phorton1/Arduino-esp32_cnc20mm/docs/projects.md

# esp32_cnc20mm - some Projects made with this CNC machine

**[Home](readme.md)** --
**[Design](design.md)** --
**[Details](details.md)** --
**[Electronics](electronics.md)** --
**[Box](box.md)** --
**[Spindle](spindle.md)** --
**[Y-Axis](y_axis.md)** --
**[Table](table.md)** --
**[Build](build.md)** --
**[Laser](laser.md)** --
**[Accessories](accessories.md)** --
**[Software](software.md)** --
**[Notes](notes.md)** --
**Projects**

- Mo's Plaque
- Mark's Emblem
- Rhapsody Engraving
- Dolphin Plaques
- Boat Numbering
- Small Things Box

New Laser

- Bocas Del Toro Box
- Fabian Box
- Wirth Boxes
- Useless Box
- Clock1 & 2
- Clock3

**Next** - back to the [**beginning**](readme.md) ...
