phorton1/Arduino-esp32_cnc20mm/docs/images/access-dust_boot2.jpg

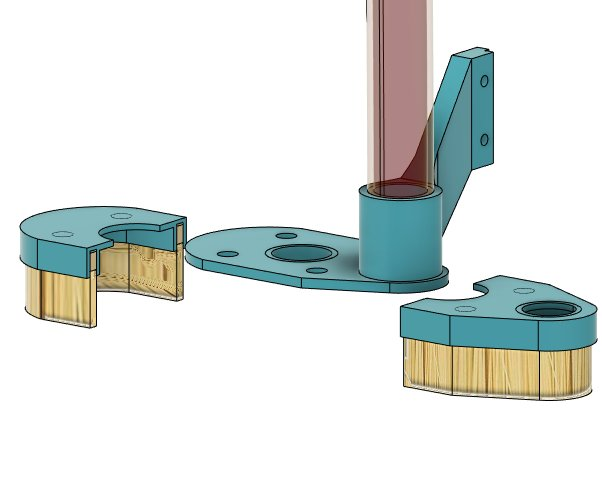
docs/images/access-dust_boot2.jpg
