phorton1/Arduino-esp32_cnc20mm/docs/images/box-CuttingWood_thumb.jpg

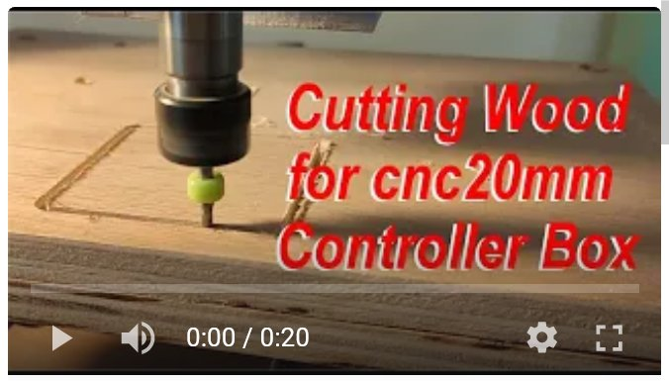
docs/images/box-CuttingWood_thumb.jpg
