phorton1/Arduino-esp32_cnc20mm/docs/images/brush.jpg

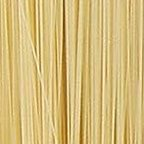
docs/images/brush.jpg
