phorton1/Arduino-esp32_cnc20mm/docs/images/design-table0.jpg

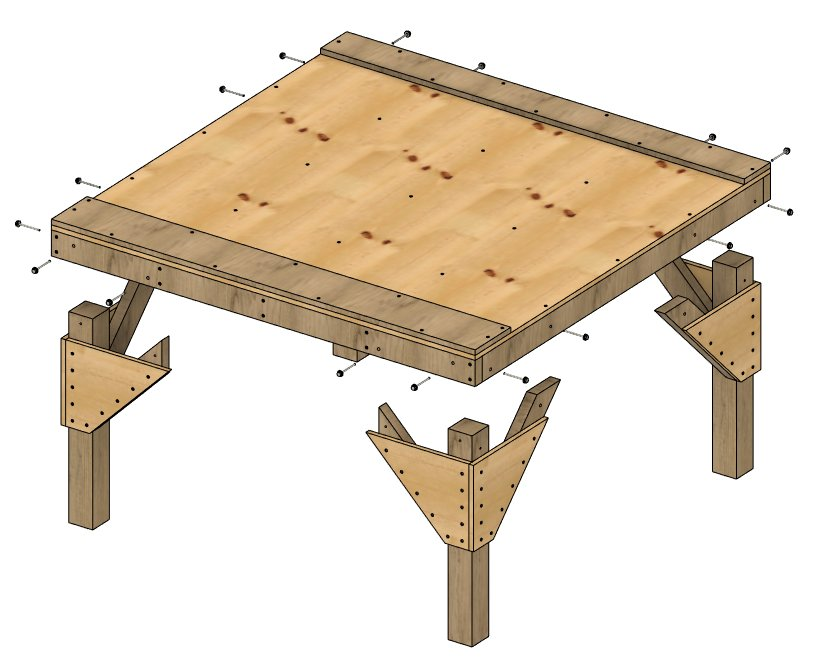
docs/images/design-table0.jpg
