phorton1/Arduino-esp32_cnc20mm/docs/z_extra/lumber_by_4s.jpg

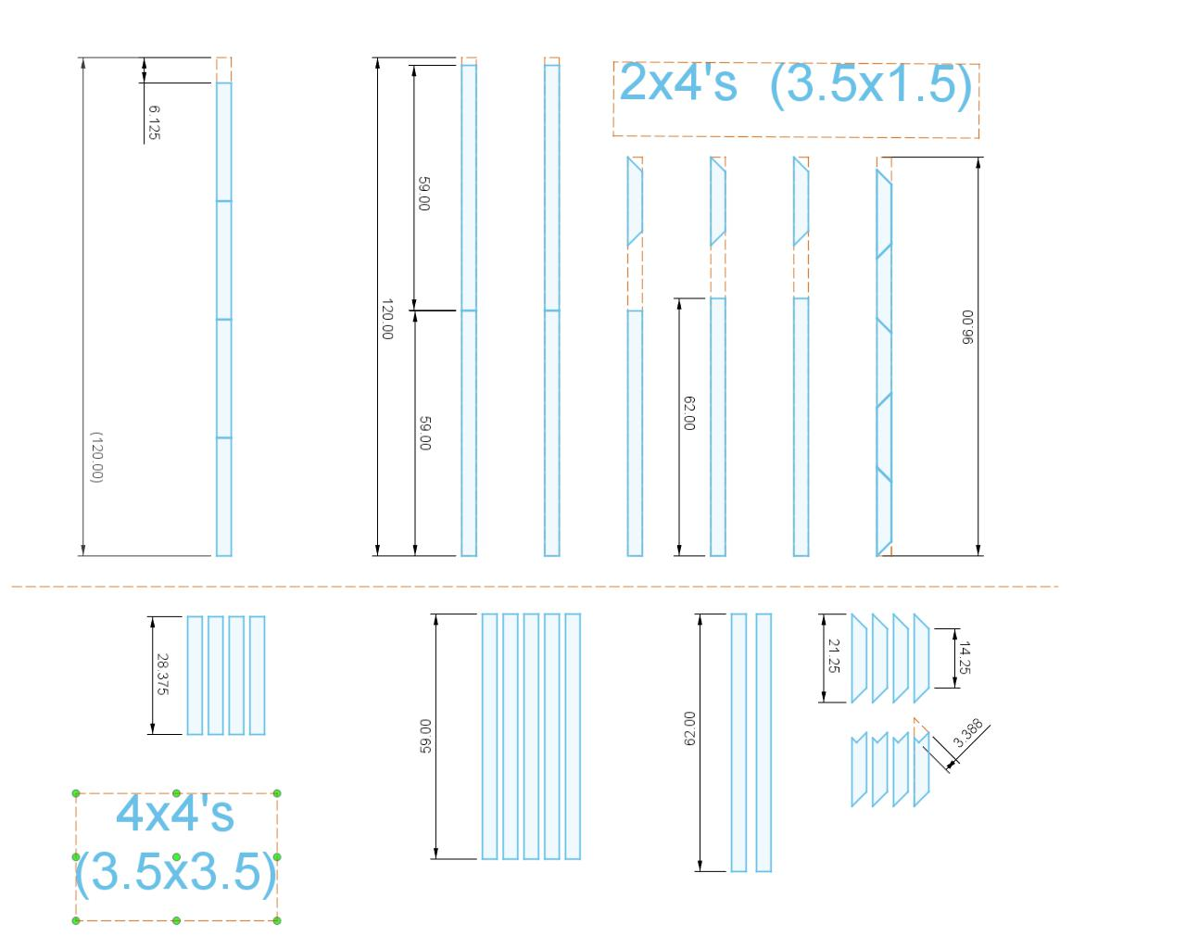
docs/z_extra/lumber_by_4s.jpg
