phorton1/Arduino-esp32_cnc20mm/docs/z_extra/plywood.jpg

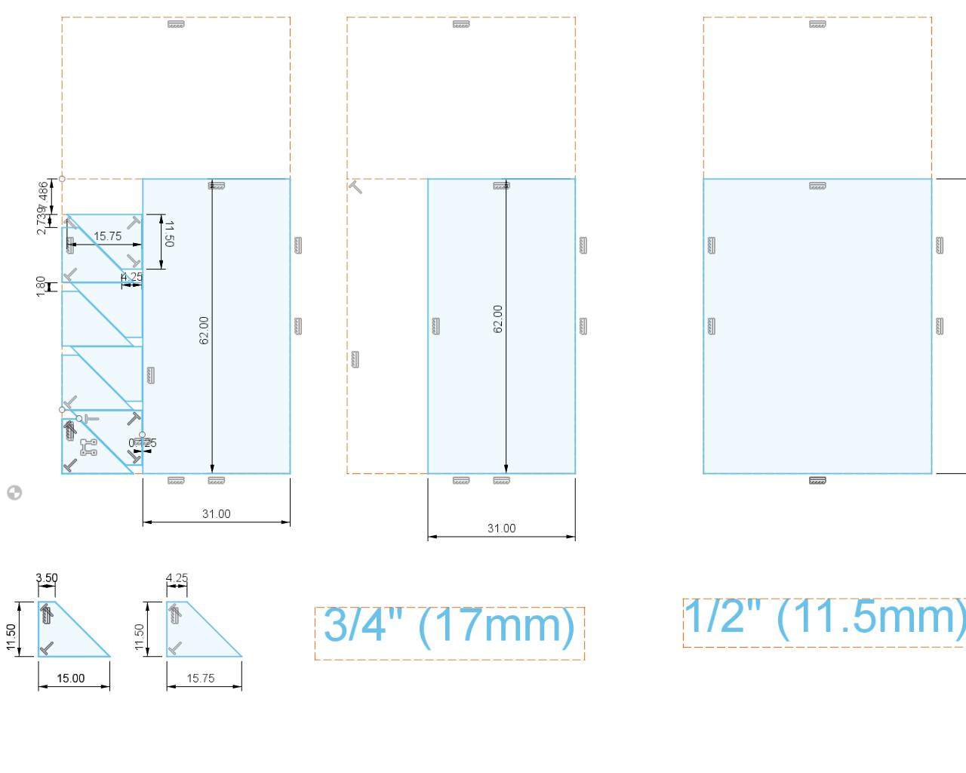
docs/z_extra/plywood.jpg
