phorton1/Arduino-esp32_cnc20mm/docs/fusion/stl_box/right_plastic.stl

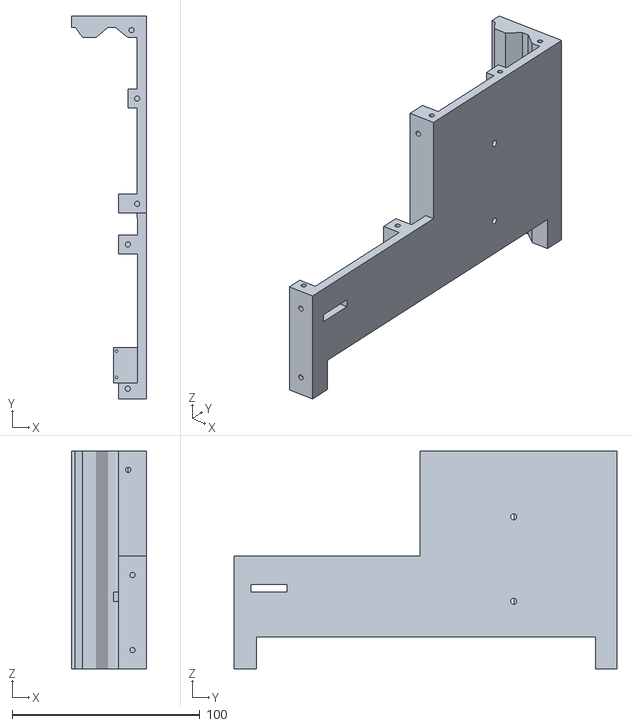
[picture p115: CAD file, 2023-07-21]
docs/fusion/stl_box/right_plastic.stl
40.0 x 204.0 x 116.0
