phorton1/Arduino-esp32_cnc20mm/docs/fusion/stl_machine/x_fixed_end.stl

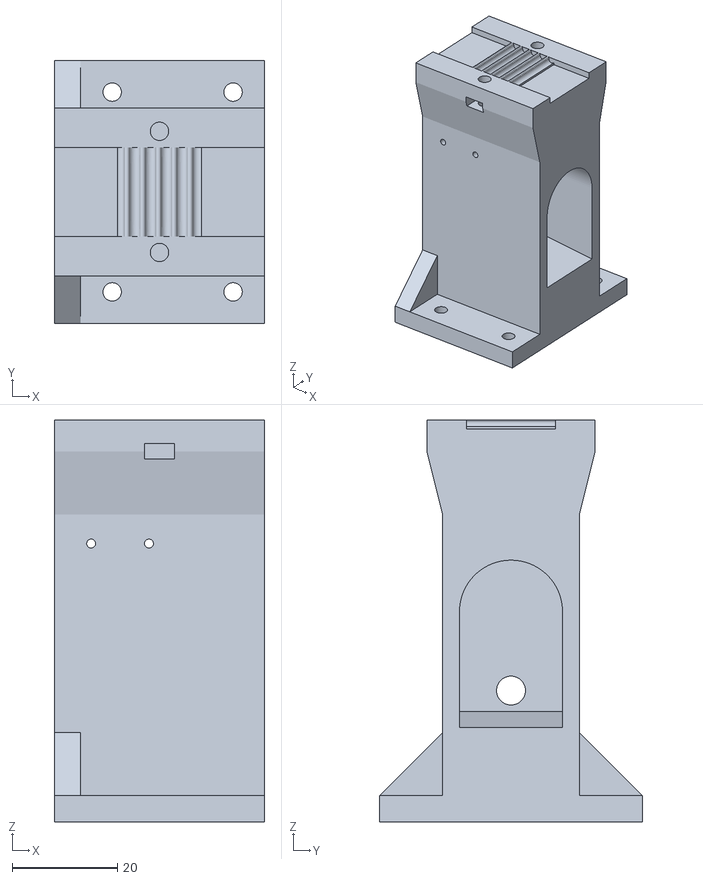
[picture p116: CAD file, 2023-07-24]
docs/fusion/stl_machine/x_fixed_end.stl
40.0 x 50.0 x 76.5
