phorton1/Arduino-esp32_cnc20mm/docs/fusion/stl_other/vacuum2_hose_connector.stl

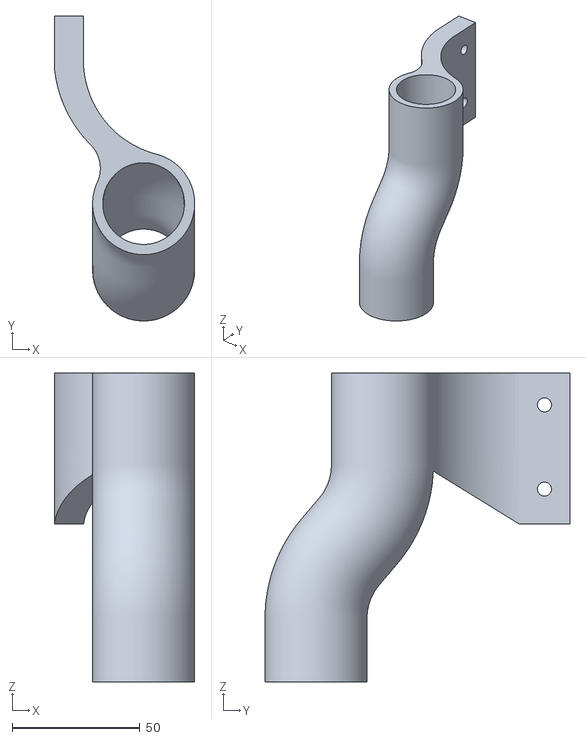
[picture p117: CAD file, 2023-07-25]
docs/fusion/stl_other/vacuum2_hose_connector.stl
55.0 x 119.5 x 121.0
