phorton1/Arduino-esp32_cnc20mm/docs/kicad/laser_board/laser_board.step

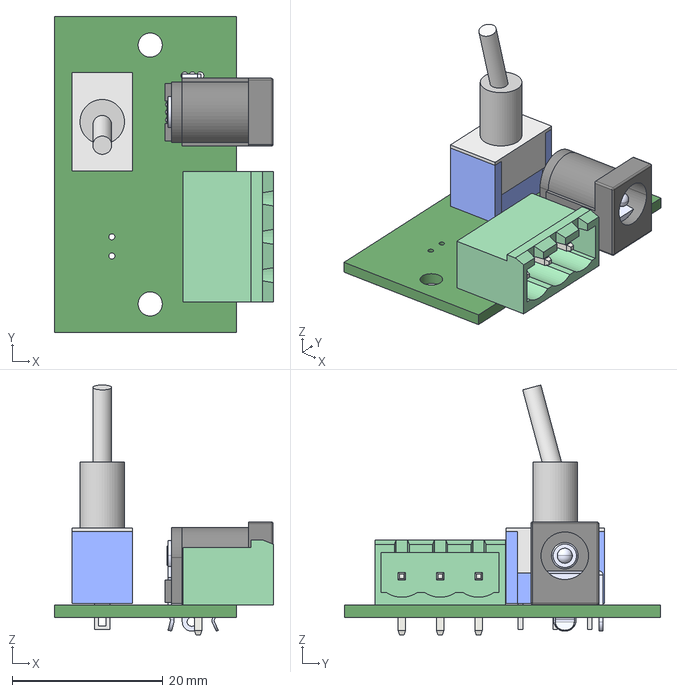
[picture p118: CAD file, 2023-07-28]
docs/kicad/laser_board/laser_board.step
29.1 x 41.9 x 33.1 mm
