phorton1/Arduino-esp32_cnc20mm/docs/prusa/box/power_connector_mount.3mf

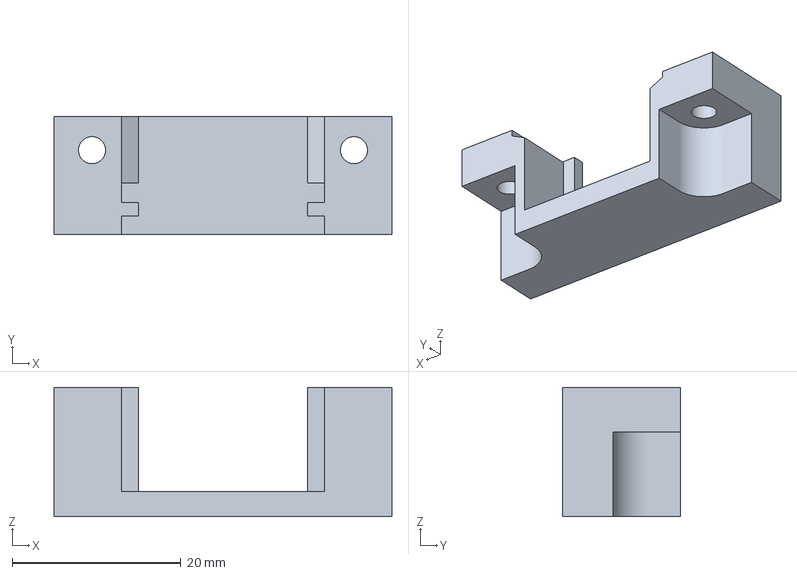
[picture p119: CAD file, 2023-07-21]
docs/prusa/box/power_connector_mount.3mf
40.0 x 14.0 x 15.3 mm
