phorton1/Arduino-esp32_cnc20mm/docs/prusa/machine/x_bearing_x_4.3mf

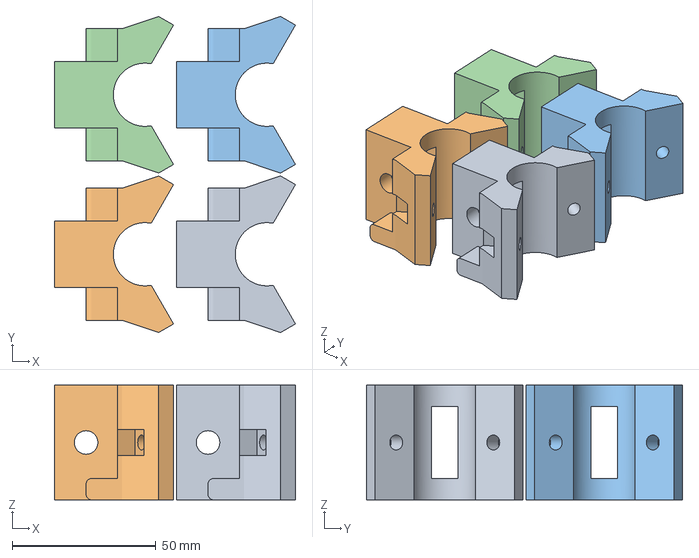
[picture p120: CAD file, 2023-07-24]
docs/prusa/machine/x_bearing_x_4.3mf
83.9 x 110.1 x 40.0 mm
x_bearing.stl x 4
