phorton1/Arduino-esp32_cnc20mm/docs/fusion/stl_box/big_mount.stl

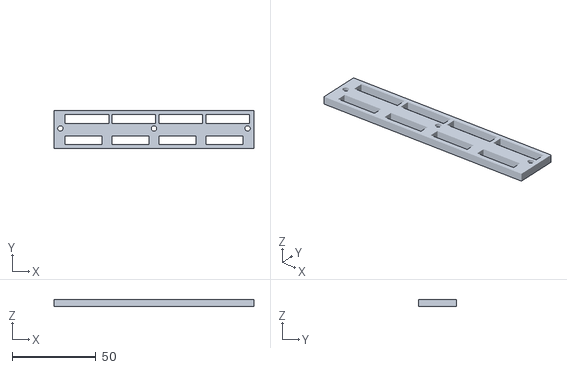
[picture p121: CAD file, 2023-07-21]
docs/fusion/stl_box/big_mount.stl
119.4 x 22.9 x 4.00
