phorton1/Arduino-esp32_cnc20mm/docs/fusion/stl_machine/x_bearing.stl

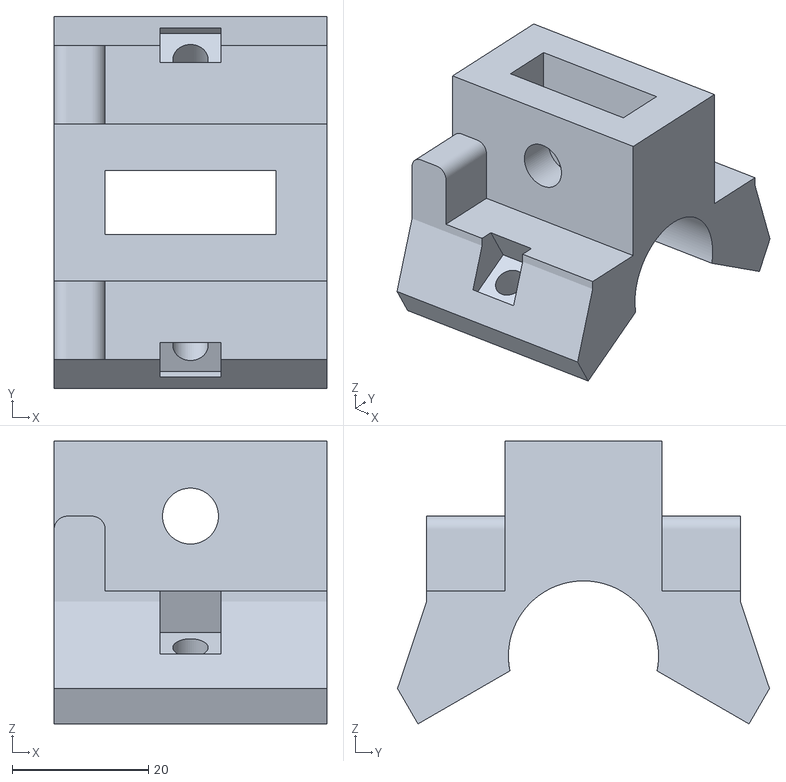
[picture p122: CAD file, 2023-07-24]
docs/fusion/stl_machine/x_bearing.stl
40.0 x 54.5 x 41.5
