phorton1/Arduino-esp32_cnc20mm/docs/fusion/stl_other/laser_scoop.stl

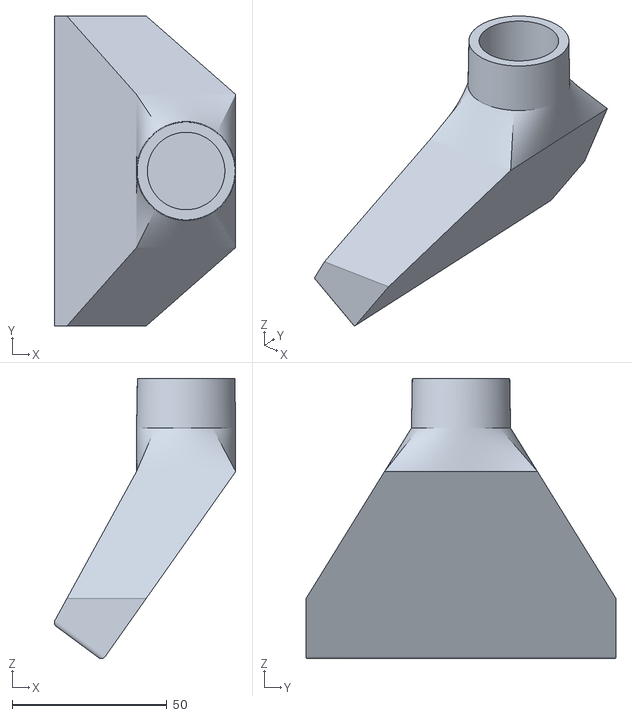
[picture p123: CAD file, 2023-07-25]
docs/fusion/stl_other/laser_scoop.stl
58.5 x 100.0 x 90.4
