phorton1/Arduino-esp32_cnc20mm/docs/prusa/machine/x_end_set.3mf

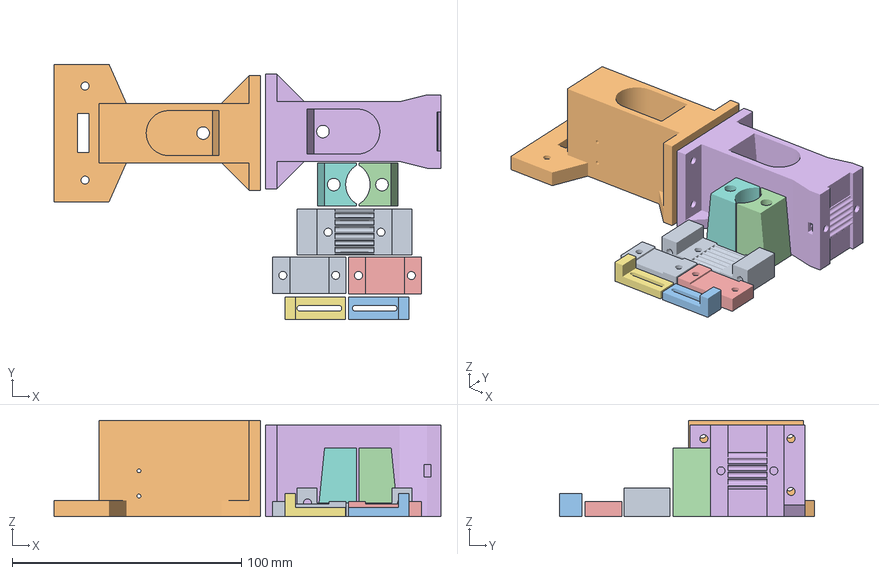
[picture p124: CAD file, 2023-07-24]
docs/prusa/machine/x_end_set.3mf
168.7 x 111.4 x 42.0 mm
x_tensioner.stl
x_adj_end.stl
x_stop.stl x 2
x_bar_tensioner.stl x 2
x_end_top.stl x 2
x_fixed_end.stl
