phorton1/Arduino-esp32_cnc20mm/docs/fusion/stl_box/middle_plastic.stl

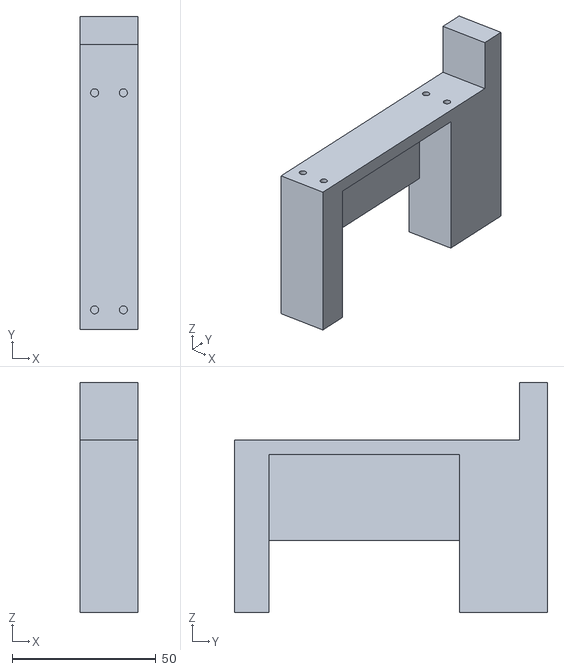
[picture p125: CAD file, 2023-07-21]
docs/fusion/stl_box/middle_plastic.stl
20.0 x 109.0 x 80.0
