phorton1/Arduino-esp32_cnc20mm/docs/fusion/stl_machine/drag_support_bracket.stl

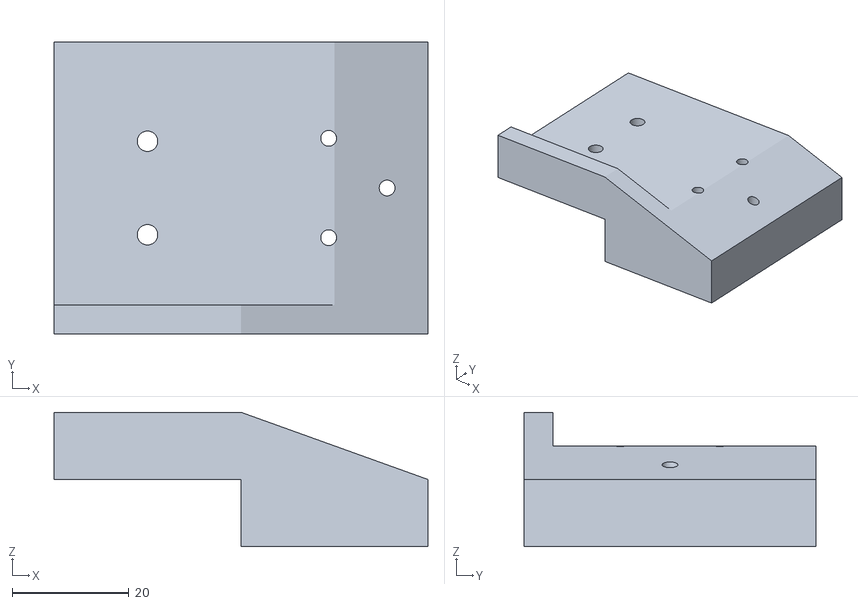
[picture p126: CAD file, 2023-07-22]
docs/fusion/stl_machine/drag_support_bracket.stl
64.0 x 50.0 x 23.0
