phorton1/Arduino-esp32_cnc20mm/docs/prusa/box/other_parts.3mf

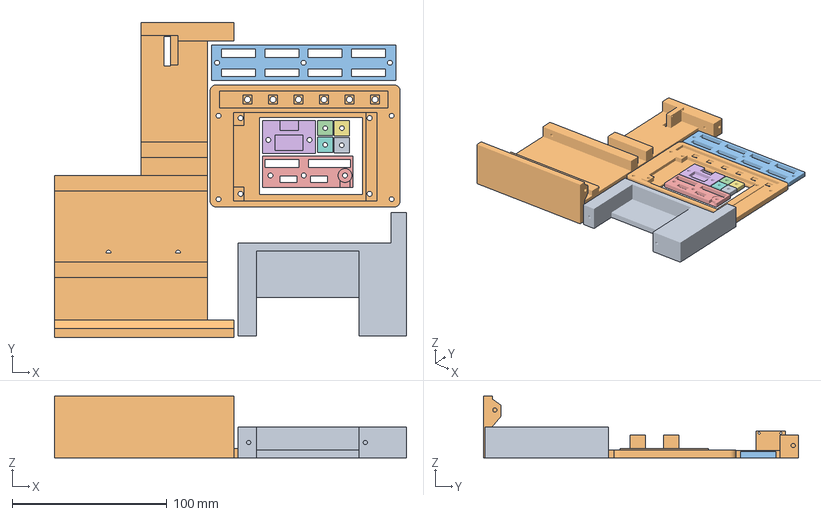
[picture p127: CAD file, 2023-07-21]
docs/prusa/box/other_parts.3mf
227.7 x 204.0 x 40.0 mm
middle_plastic.stl
screen_mount.stl
big_mount.stl
pcb_mount.stl x 4
small_mount.stl
usb_mount.stl
right_plastic.stl
