phorton1/Arduino-esp32_cnc20mm/docs/prusa/other/laser_scoop.3mf

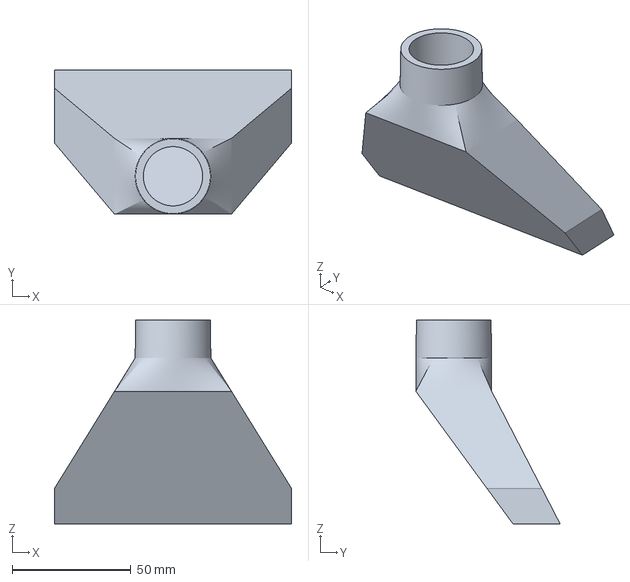
[picture p128: CAD file, 2023-07-25]
docs/prusa/other/laser_scoop.3mf
100.0 x 60.9 x 86.0 mm
