phorton1/Arduino-esp32_cnc20mm/docs/fusion/stl_machine/y_tensioner.stl

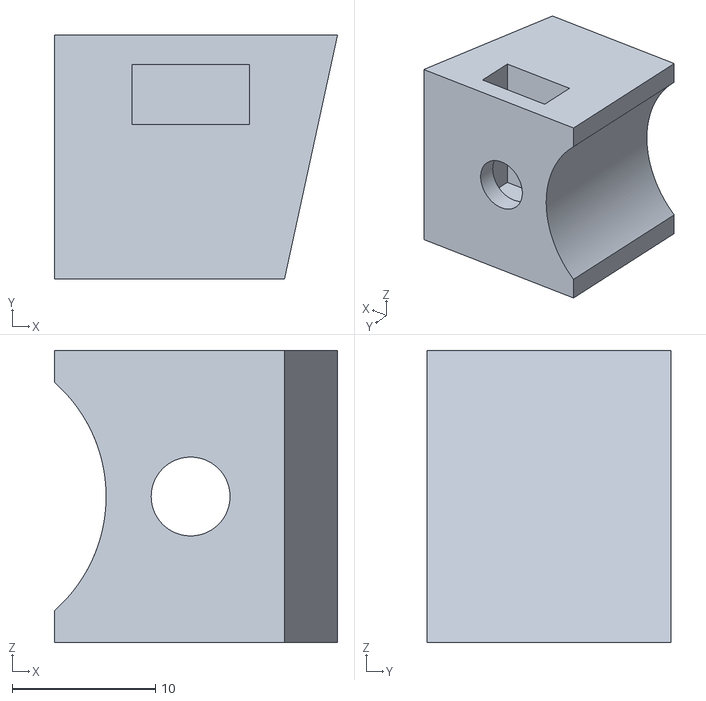
[picture p129: CAD file, 2023-07-21]
docs/fusion/stl_machine/y_tensioner.stl
19.8 x 17.0 x 20.4
