phorton1/Arduino-esp32_cnc20mm/docs/fusion/stl_other/wire_clamp1.stl

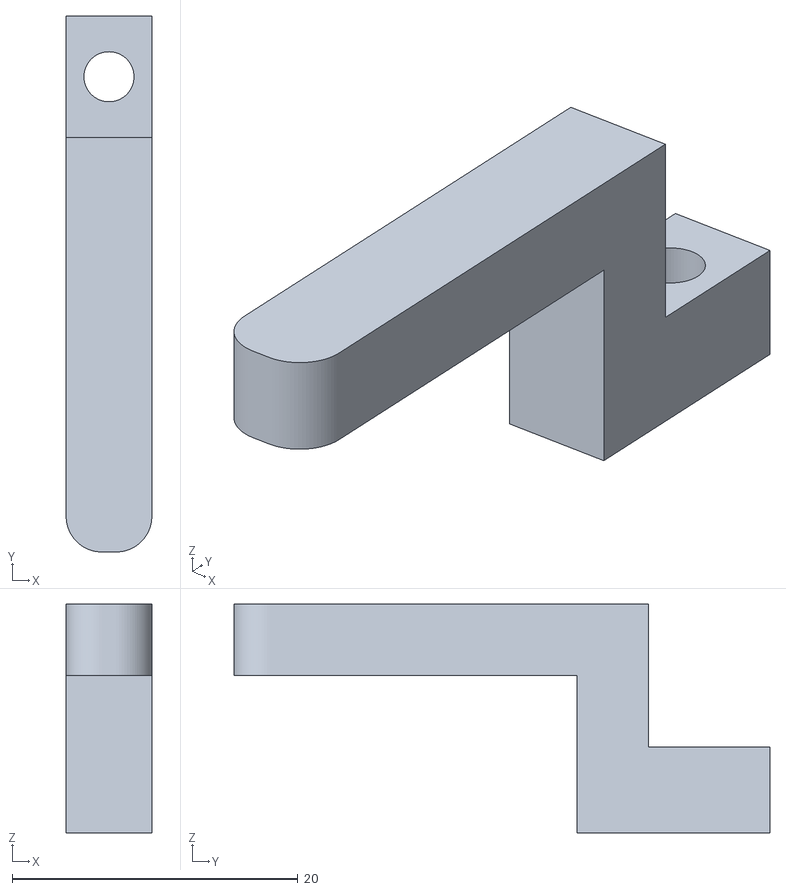
[picture p130: CAD file, 2023-07-21]
docs/fusion/stl_other/wire_clamp1.stl
6.00 x 37.5 x 16.0
