phorton1/Arduino-esp32_cnc20mm/docs/prusa/box/left_plastic.3mf

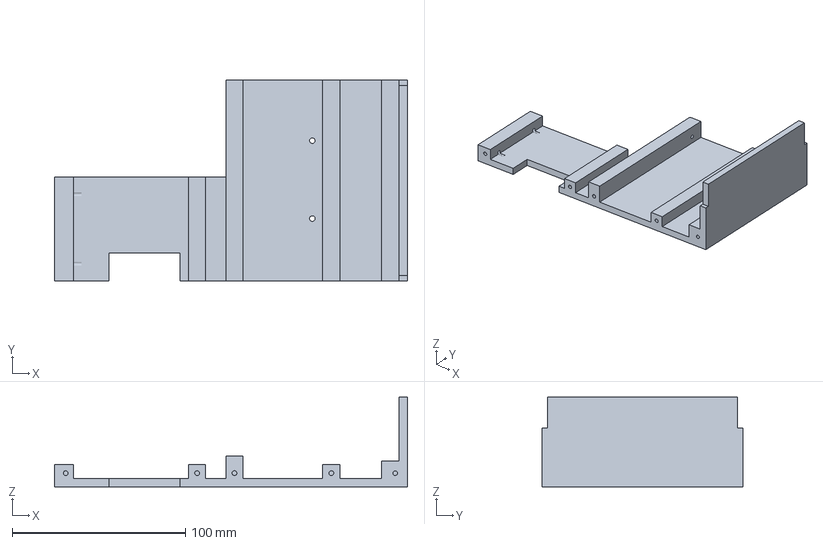
[picture p131: CAD file, 2023-07-21]
docs/prusa/box/left_plastic.3mf
204.0 x 116.0 x 52.0 mm
