phorton1/Arduino-esp32_cnc20mm/docs/prusa/machine/x_tensioner.3mf

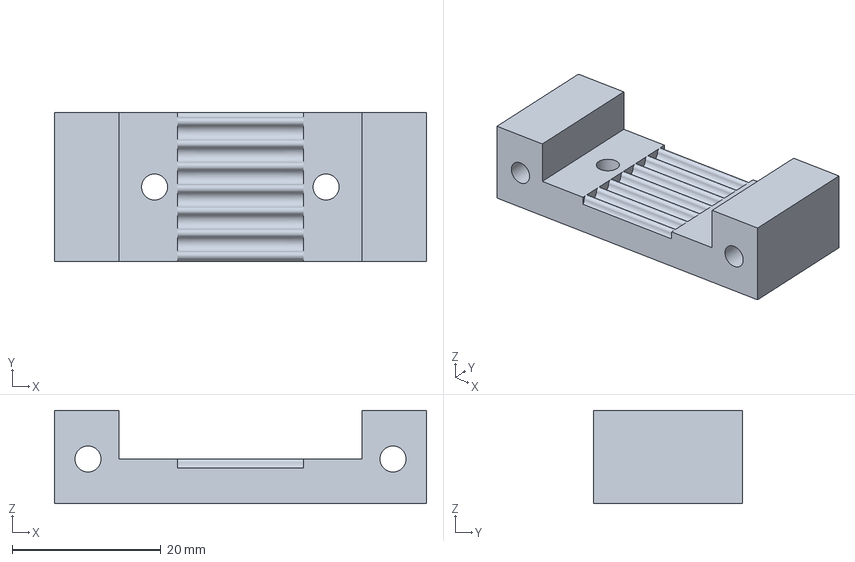
[picture p132: CAD file, 2023-07-21]
docs/prusa/machine/x_tensioner.3mf
50.0 x 20.0 x 12.5 mm
