phorton1/Arduino-esp32_cnc20mm/docs/prusa/other/10mm_hose_clamp.3mf

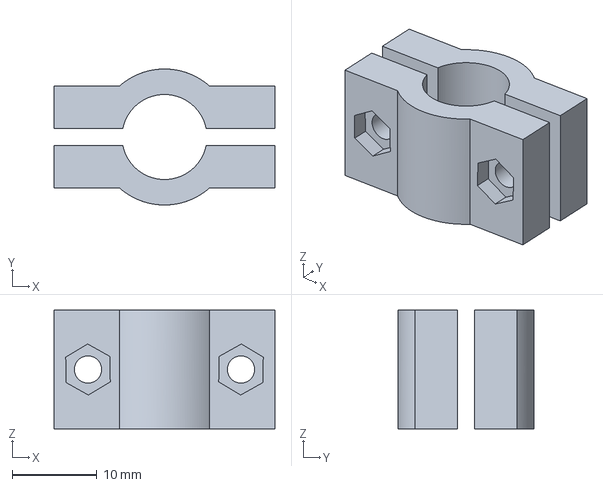
[picture p133: CAD file, 2023-07-21]
docs/prusa/other/10mm_hose_clamp.3mf
26.0 x 16.0 x 14.0 mm
