phorton1/Arduino-esp32_cnc20mm/docs/fusion/stl_machine/y_drag_bracket.stl

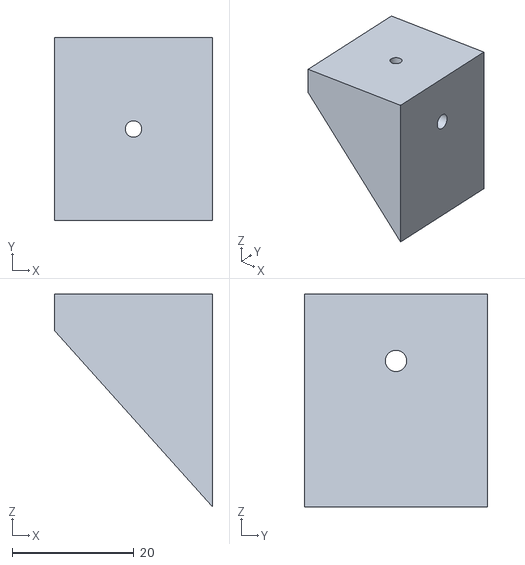
[picture p134: CAD file, 2023-07-21]
docs/fusion/stl_machine/y_drag_bracket.stl
26.0 x 30.0 x 35.0
