phorton1/Arduino-esp32_cnc20mm/docs/fusion/stl_other/vacuum_base_attacher.stl

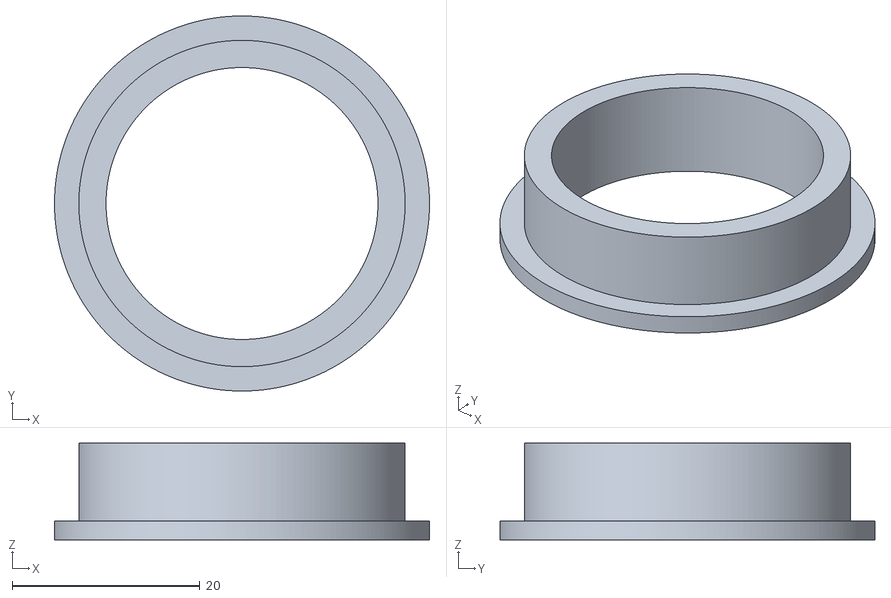
[picture p135: CAD file, 2023-07-21]
docs/fusion/stl_other/vacuum_base_attacher.stl
40.0 x 40.0 x 10.3
