phorton1/Arduino-esp32_cnc20mm/docs/prusa/box/spindle_box_cover.3mf

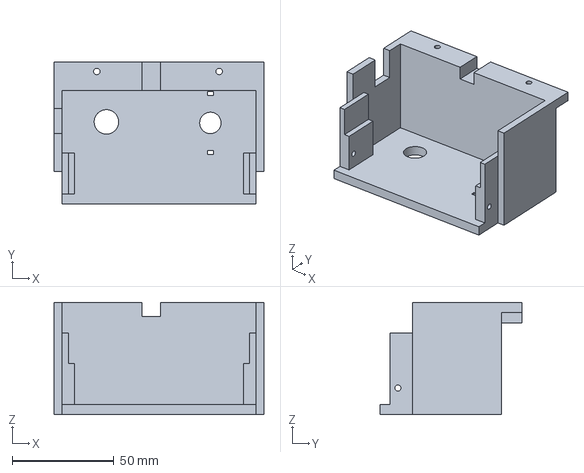
[picture p136: CAD file, 2023-07-21]
docs/prusa/box/spindle_box_cover.3mf
103.0 x 69.7 x 55.0 mm
