phorton1/Arduino-esp32_cnc20mm/docs/prusa/machine/x_tube_support.3mf

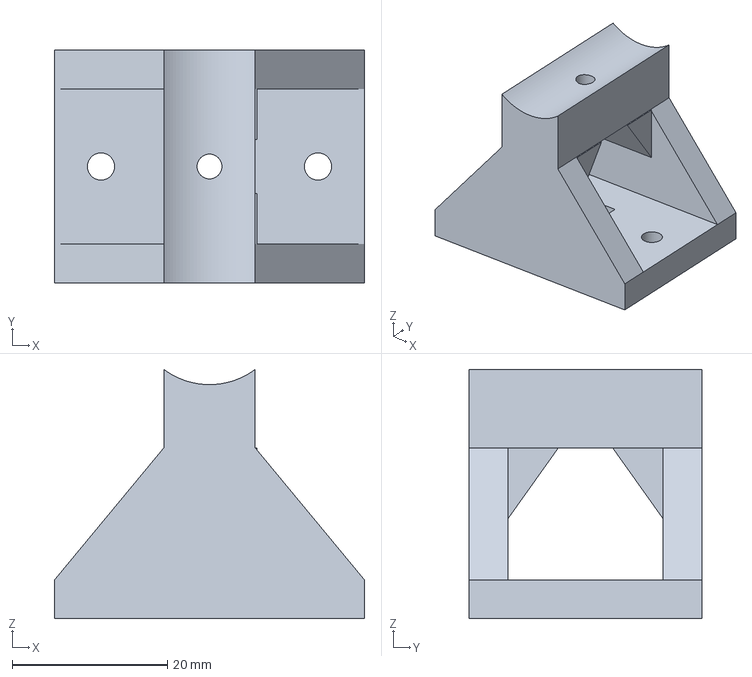
[picture p137: CAD file, 2023-07-21]
docs/prusa/machine/x_tube_support.3mf
40.0 x 30.0 x 32.2 mm
