phorton1/Arduino-esp32_cnc20mm/docs/prusa/other/connector_brackets1.3mf

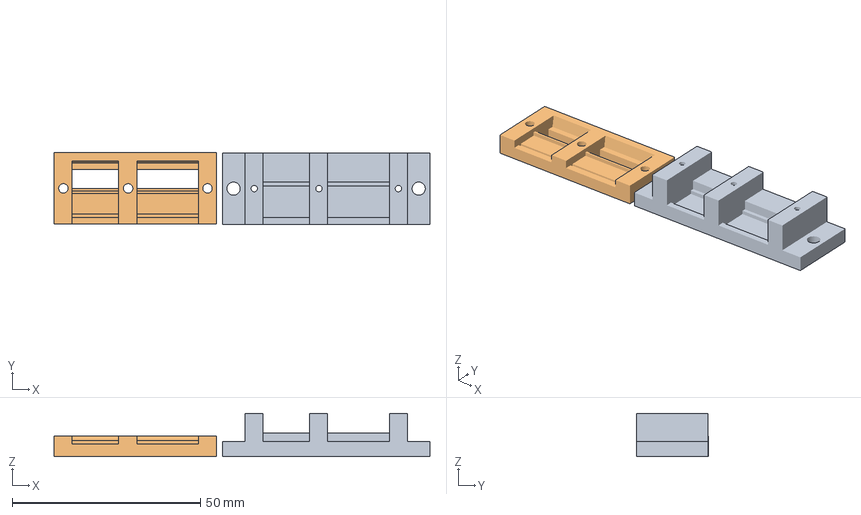
[picture p138: CAD file, 2023-07-21]
docs/prusa/other/connector_brackets1.3mf
99.9 x 19.1 x 11.5 mm
four_three_base.stl
four_three_top.stl
