phorton1/Arduino-esp32_cnc20mm/docs/fusion/stl_box/laser_board_mount.stl

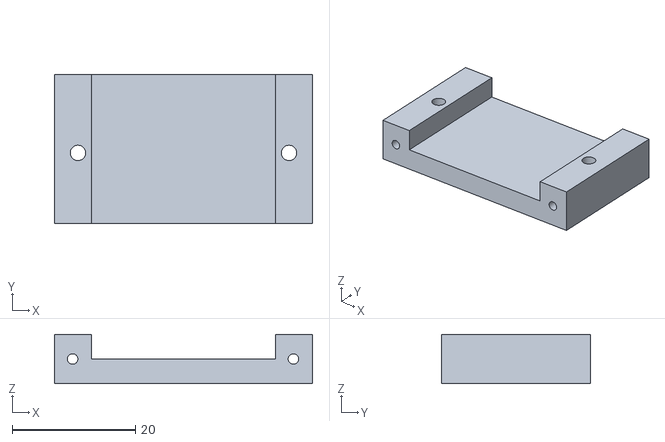
[picture p139: CAD file, 2023-07-21]
docs/fusion/stl_box/laser_board_mount.stl
41.9 x 24.1 x 8.00
