phorton1/Arduino-esp32_cnc20mm/docs/prusa/machine/z_lim_set.3mf

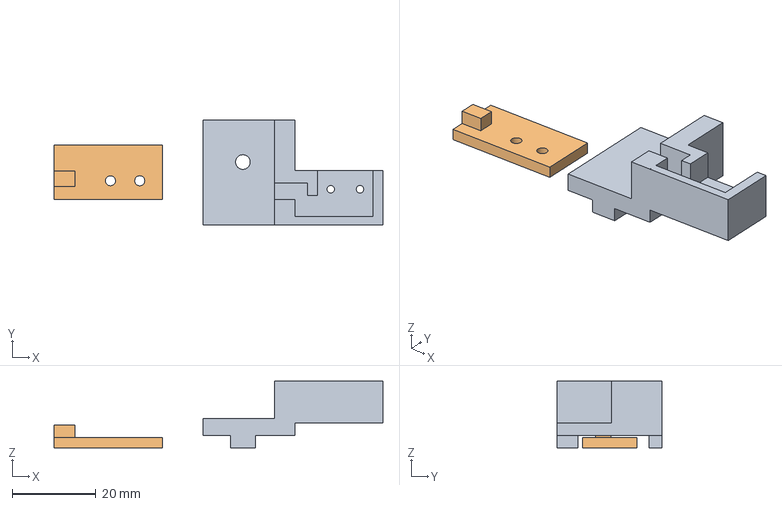
[picture p141: CAD file, 2023-07-21]
docs/prusa/machine/z_lim_set.3mf
78.7 x 25.0 x 16.0 mm
z_lim_base.stl
z_lim_cover.stl
