phorton1/Arduino-esp32_cnc20mm/docs/prusa/other/vacuum_attachment.3mf

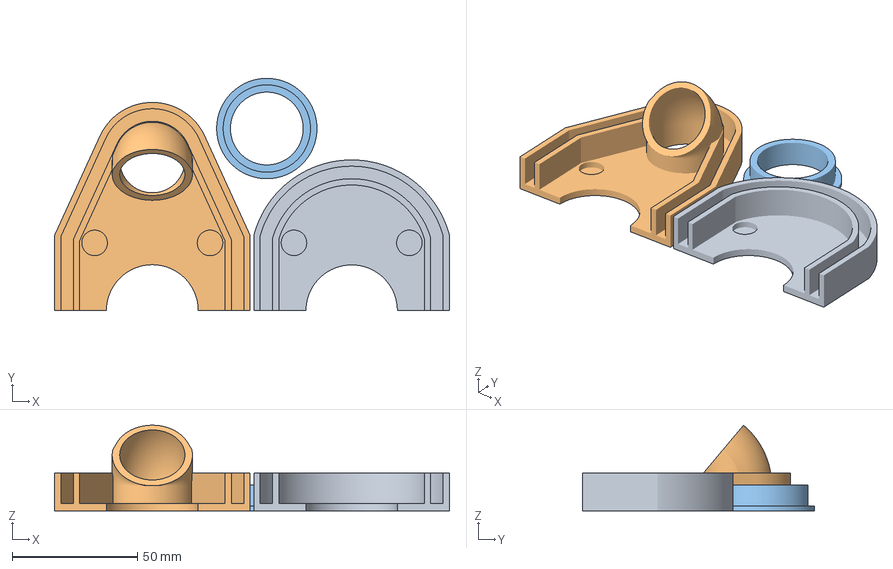
[picture p142: CAD file, 2023-07-21]
docs/prusa/other/vacuum_attachment.3mf
157.5 x 92.6 x 34.1 mm
vacuum_boot2.stl
vacuum_boot1.stl
vacuum_base_attacher.stl
