phorton1/Arduino-esp32_cnc20mm/docs/fusion/stl_box/screen_mount.stl

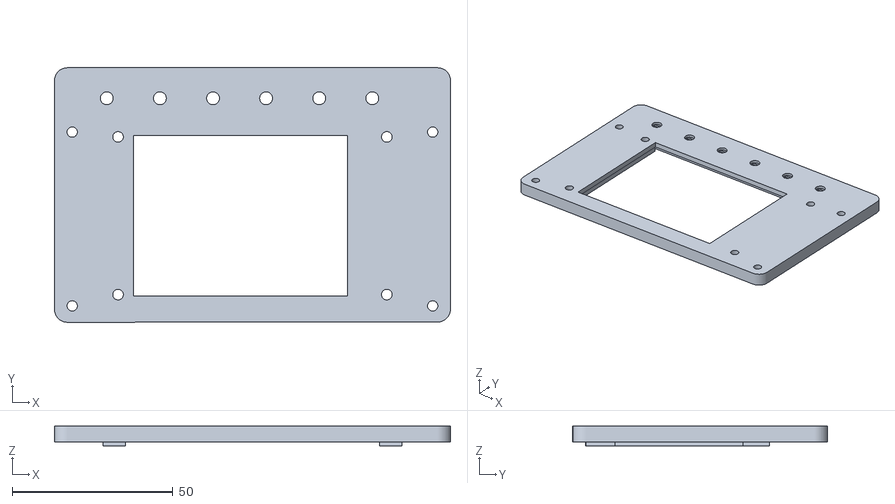
[picture p143: CAD file, 2023-07-21]
docs/fusion/stl_box/screen_mount.stl
123.0 x 79.1 x 6.20
