phorton1/Arduino-esp32_cnc20mm/docs/fusion/stl_machine/z_lim_cover.stl

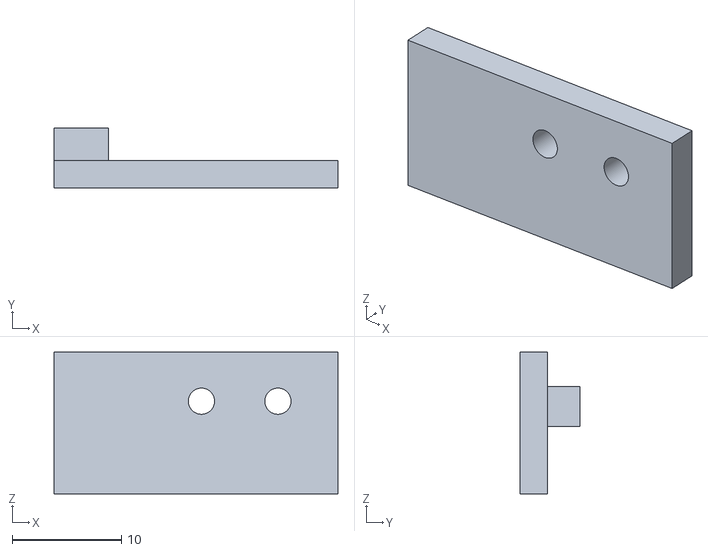
[picture p144: CAD file, 2023-07-21]
docs/fusion/stl_machine/z_lim_cover.stl
26.0 x 5.50 x 13.0
