phorton1/Arduino-esp32_cnc20mm/docs/fusion/stl_other/vacuum_boot1.stl

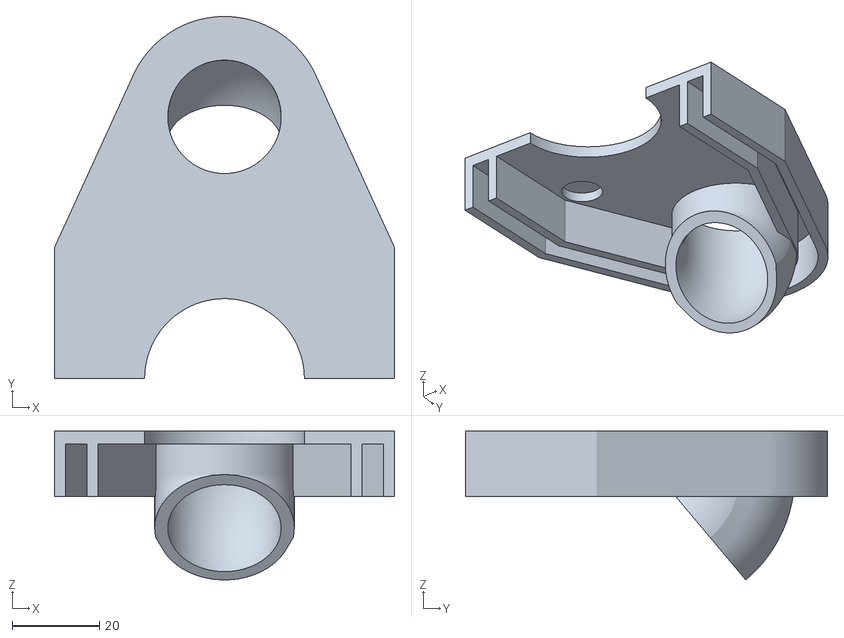
[picture p145: CAD file, 2023-07-21]
docs/fusion/stl_other/vacuum_boot1.stl
78.0 x 83.0 x 34.1
