phorton1/Arduino-esp32_cnc20mm/docs/prusa/machine/y_connector.3mf

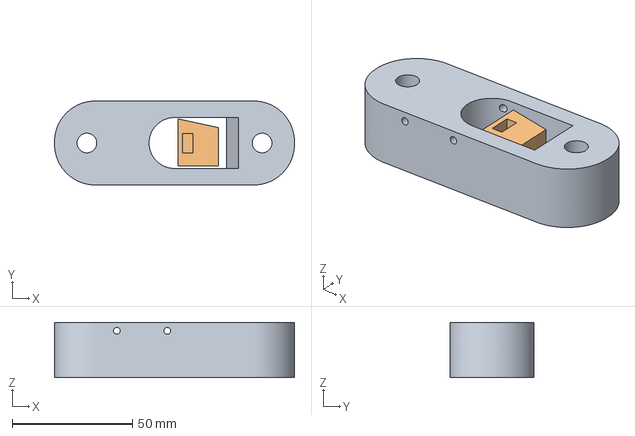
[picture p146: CAD file, 2023-07-21]
docs/prusa/machine/y_connector.3mf
100.0 x 35.0 x 23.0 mm
y_connector.stl
y_tensioner.stl
