phorton1/Arduino-esp32_cnc20mm/docs/prusa/other/vacuum_base.3mf

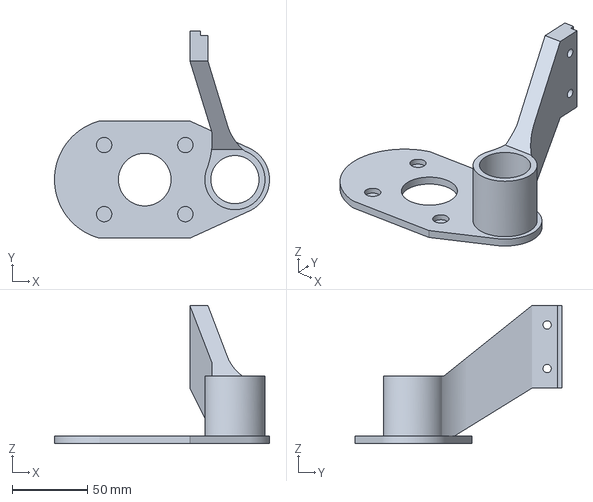
[picture p147: CAD file, 2023-07-21]
docs/prusa/other/vacuum_base.3mf
143.0 x 138.0 x 91.9 mm
