phorton1/Arduino-esp32_cnc20mm/docs/fusion/stl_other/vacuum_boot2.stl

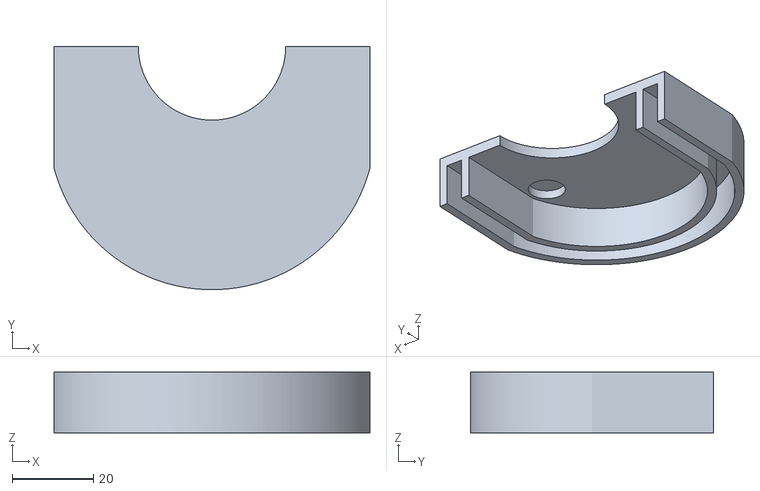
[picture p149: CAD file, 2023-07-21]
docs/fusion/stl_other/vacuum_boot2.stl
78.0 x 60.1 x 15.0
