phorton1/Arduino-esp32_cnc20mm/docs/prusa/machine/y_drag_support_brackets.3mf

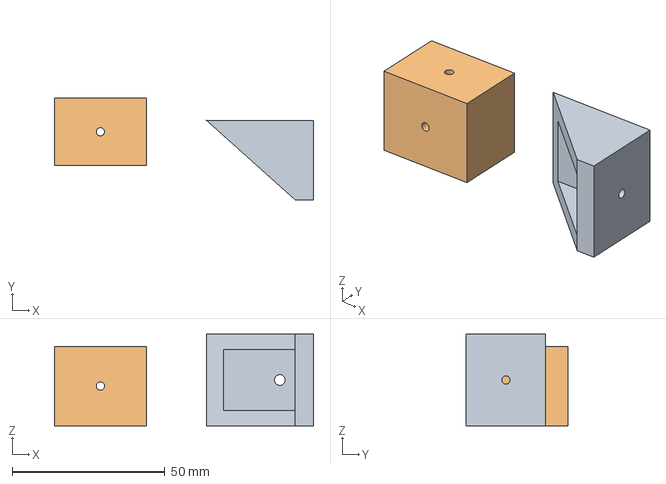
[picture p150: CAD file, 2023-07-21]
docs/prusa/machine/y_drag_support_brackets.3mf
84.7 x 33.3 x 30.0 mm
y_drag_bracket.stl
y_drag_spacer.stl
