phorton1/Arduino-esp32_cnc20mm/docs/fusion/stl_box/pcb_mount.stl

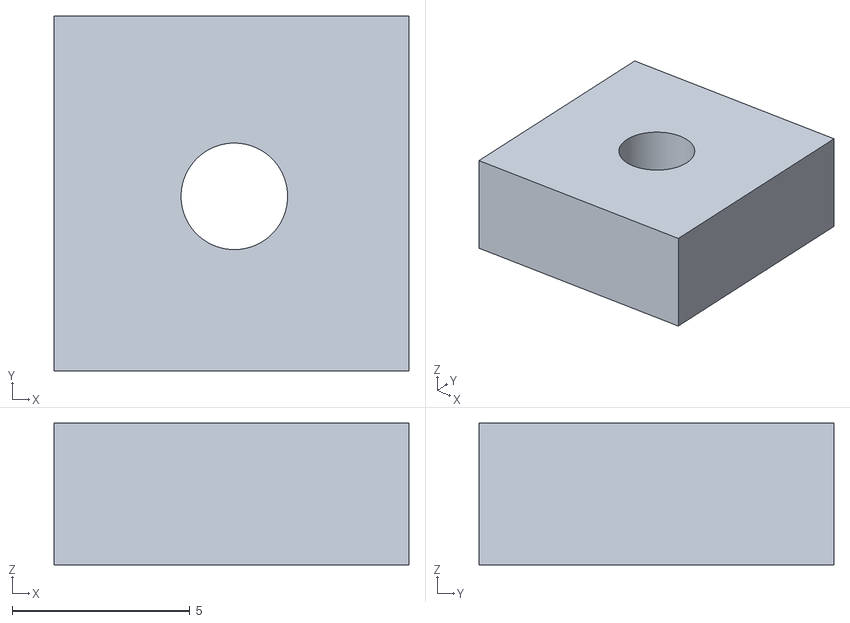
[picture p151: CAD file, 2023-07-21]
docs/fusion/stl_box/pcb_mount.stl
10.0 x 10.0 x 4.00
