phorton1/Arduino-esp32_cnc20mm/docs/fusion/stl_machine/y_tensioner_plate.stl

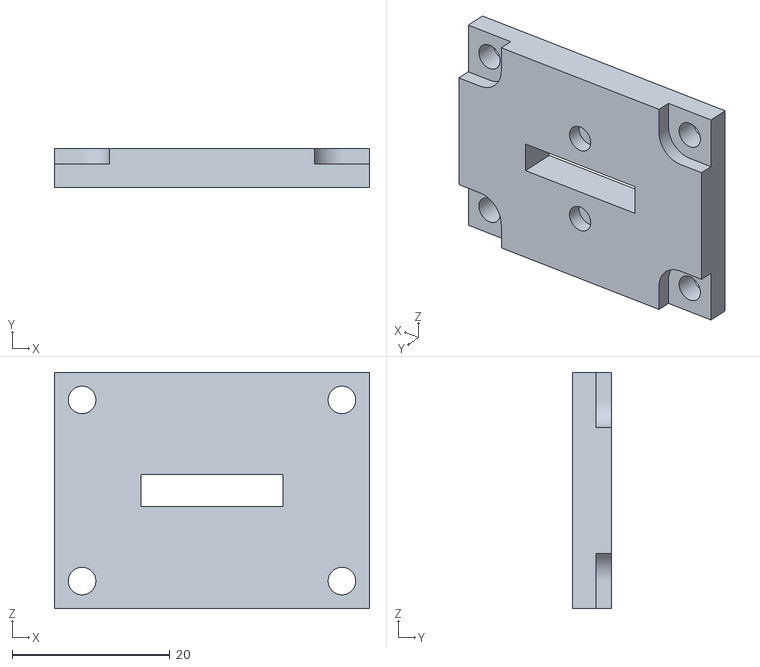
[picture p152: CAD file, 2023-07-21]
docs/fusion/stl_machine/y_tensioner_plate.stl
40.0 x 5.00 x 30.0
