phorton1/Arduino-esp32_cnc20mm/docs/prusa/machine/x_tube_support_x_8.3mf

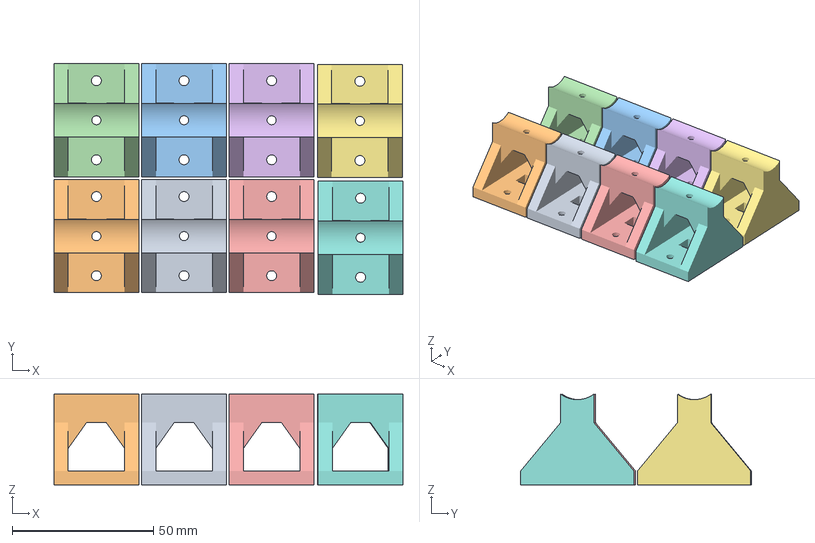
[picture p153: CAD file, 2023-07-21]
docs/prusa/machine/x_tube_support_x_8.3mf
123.5 x 81.6 x 32.2 mm
x_tube_support.stl x 8
