phorton1/Arduino-esp32_cnc20mm/docs/fusion/stl_box/small_mount.stl

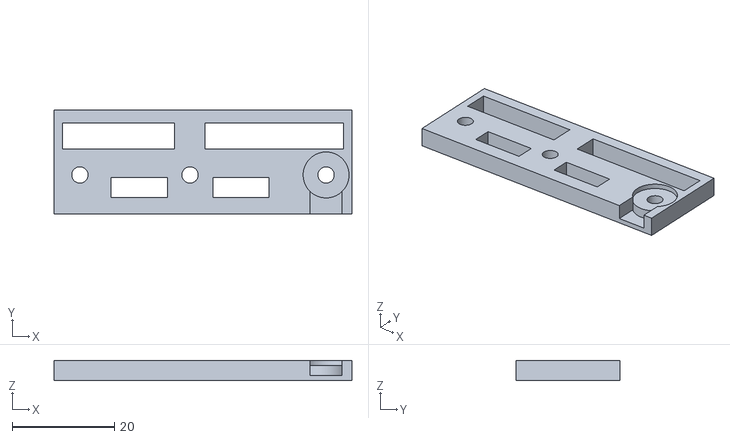
[picture p154: CAD file, 2023-07-21]
docs/fusion/stl_box/small_mount.stl
58.4 x 20.3 x 4.00
