phorton1/Arduino-esp32_cnc20mm/docs/fusion/stl_machine/y_drag_support.stl

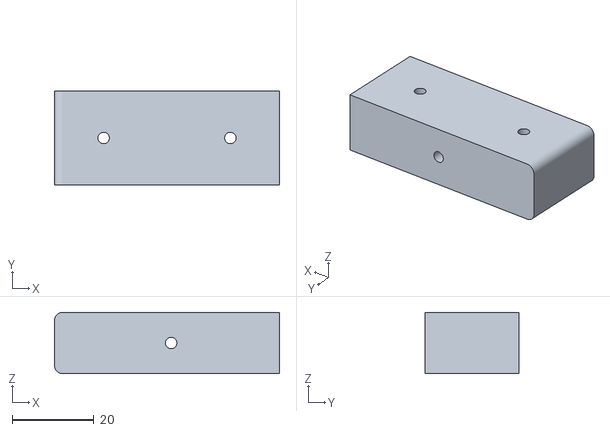
[picture p155: CAD file, 2023-07-21]
docs/fusion/stl_machine/y_drag_support.stl
55.0 x 23.0 x 15.0
