phorton1/Arduino-esp32_cnc20mm/docs/fusion/stl_other/four_three_base.stl

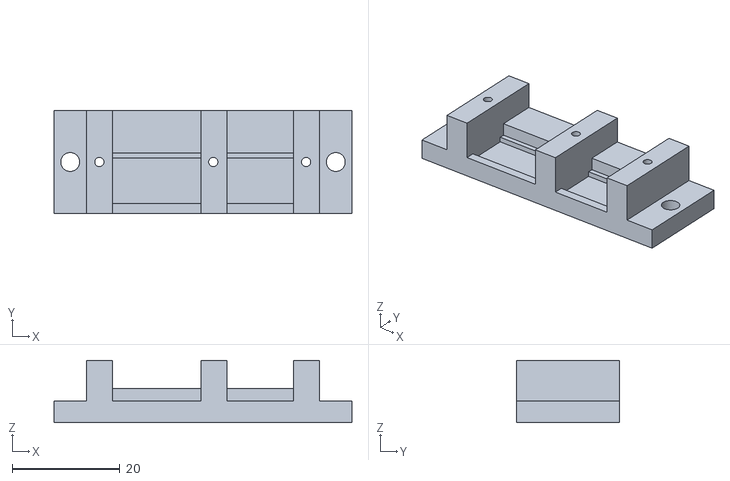
[picture p156: CAD file, 2023-07-21]
docs/fusion/stl_other/four_three_base.stl
55.2 x 19.0 x 11.5
