phorton1/Arduino-esp32_cnc20mm/docs/prusa/machine/z_zero_set.3mf

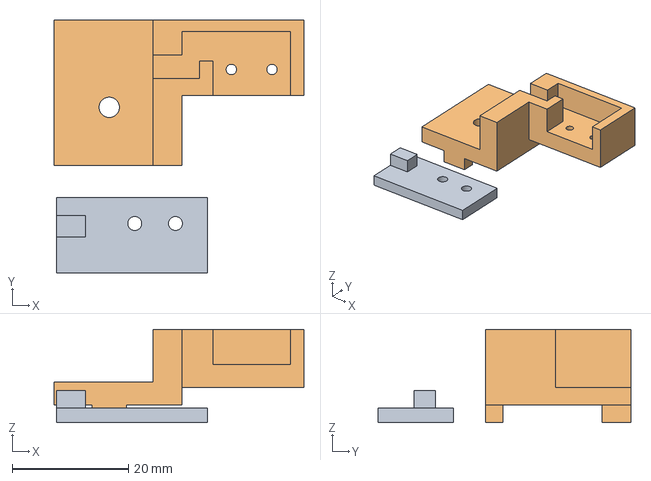
[picture p157: CAD file, 2023-07-21]
docs/prusa/machine/z_zero_set.3mf
43.0 x 43.5 x 16.0 mm
z_zero_cover.stl
z_zero_base.stl
