phorton1/Arduino-esp32_cnc20mm/docs/fusion/stl_box/usb_mount.stl

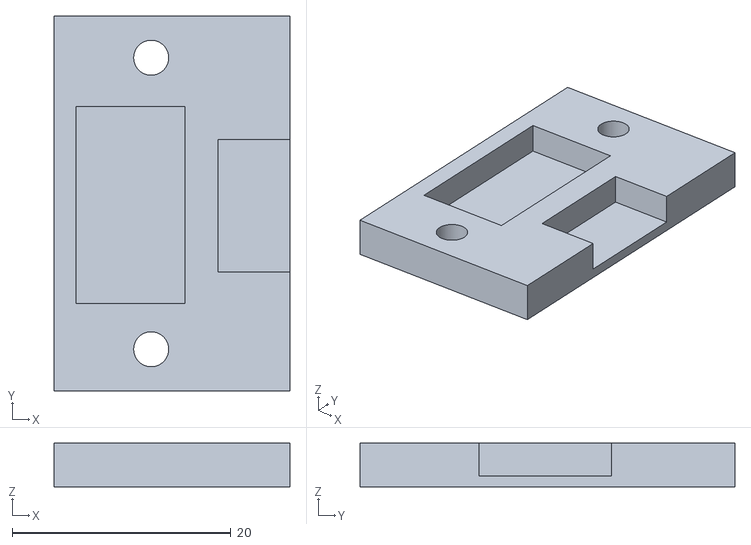
[picture p158: CAD file, 2023-07-21]
docs/fusion/stl_box/usb_mount.stl
21.6 x 34.3 x 4.00
