phorton1/Arduino-esp32_cnc20mm/docs/fusion/stl_machine/y_tensioner_top.stl

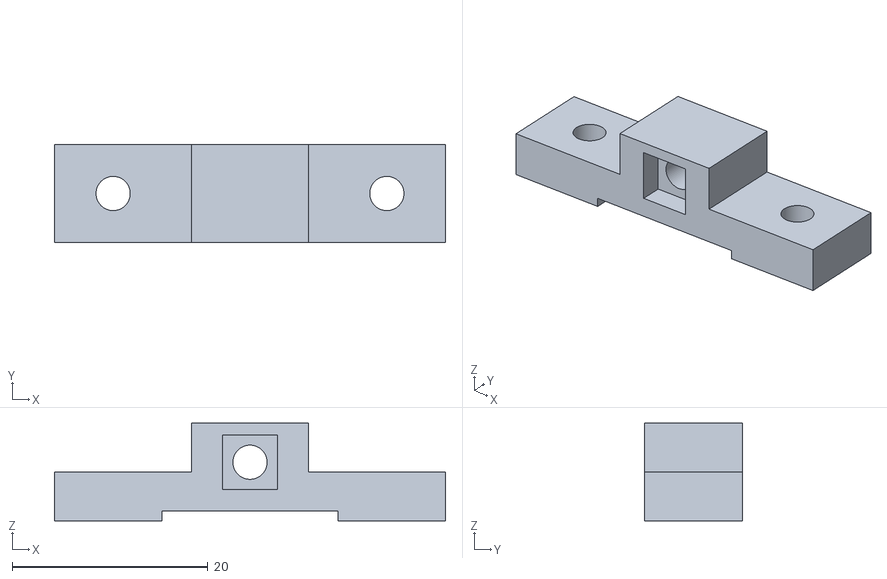
[picture p159: CAD file, 2023-07-21]
docs/fusion/stl_machine/y_tensioner_top.stl
40.0 x 10.0 x 10.0
