phorton1/Arduino-esp32_cnc20mm/docs/fusion/stl_other/three_two_base.stl

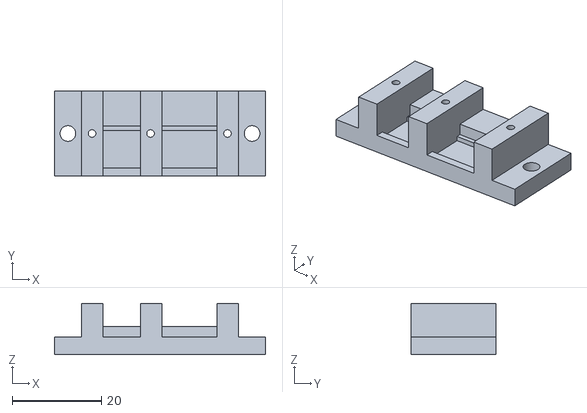
[picture p160: CAD file, 2023-07-21]
docs/fusion/stl_other/three_two_base.stl
47.2 x 19.0 x 11.5
