phorton1/Arduino-esp32_cnc20mm/docs/prusa/machine/y_drag_support_x_2.3mf

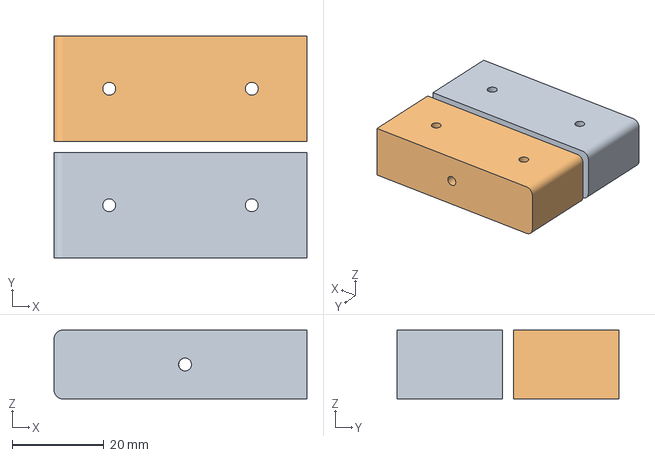
[picture p161: CAD file, 2023-07-21]
docs/prusa/machine/y_drag_support_x_2.3mf
55.0 x 48.4 x 15.0 mm
y_drag_support.stl x 2
