phorton1/Arduino-esp32_cnc20mm/docs/fusion/stl_machine/z_lim_base.stl

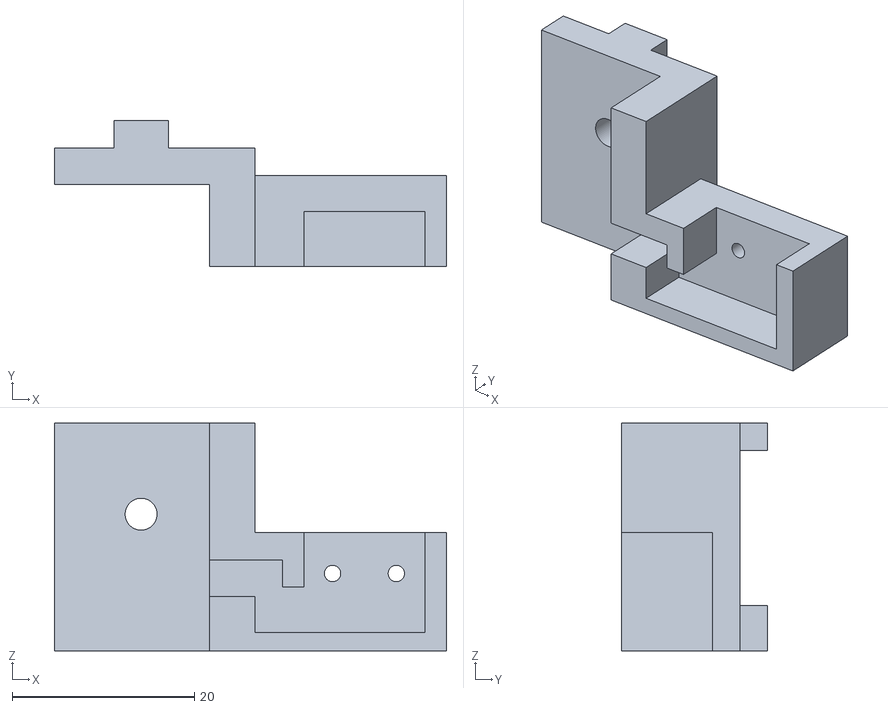
[picture p162: CAD file, 2023-07-21]
docs/fusion/stl_machine/z_lim_base.stl
43.0 x 16.0 x 25.0
