phorton1/Arduino-esp32_cnc20mm/docs/fusion/stl_machine/y_bearing_half.stl

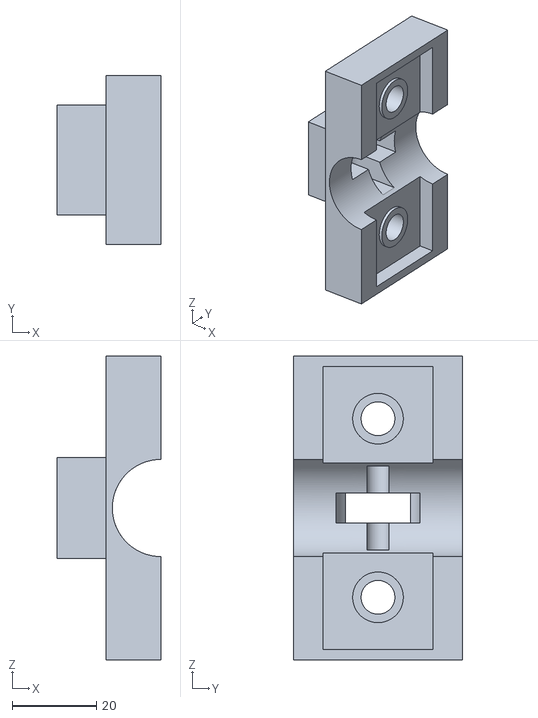
[picture p163: CAD file, 2023-07-21]
docs/fusion/stl_machine/y_bearing_half.stl
24.7 x 40.0 x 72.0
