phorton1/Arduino-esp32_cnc20mm/docs/fusion/stl_other/four_base.stl

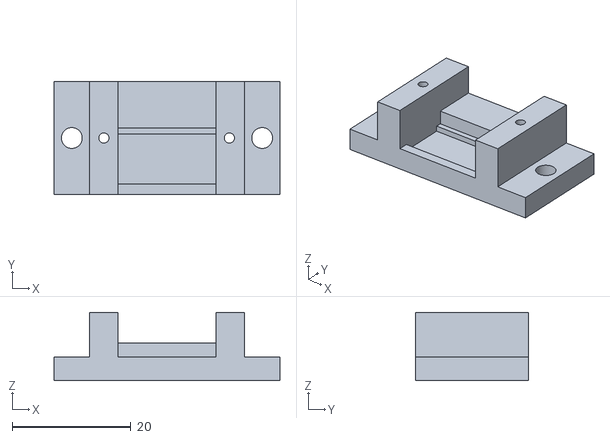
[picture p164: CAD file, 2023-07-21]
docs/fusion/stl_other/four_base.stl
38.0 x 19.0 x 11.5
