phorton1/Arduino-esp32_cnc20mm/docs/prusa/machine/last_black_parts.3mf

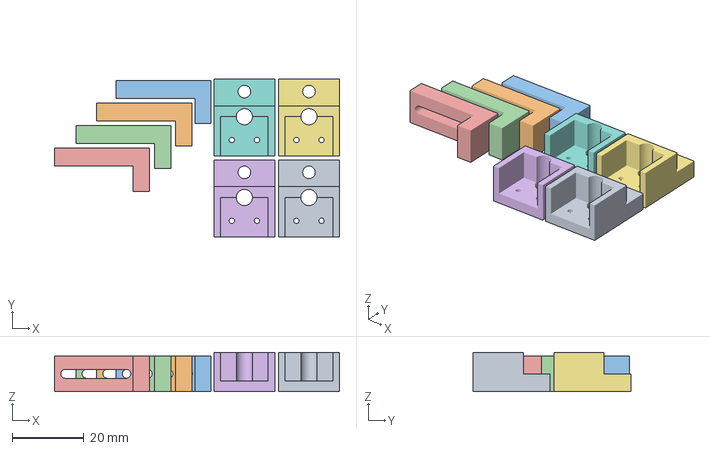
[picture p165: CAD file, 2023-07-21]
docs/prusa/machine/last_black_parts.3mf
79.4 x 44.0 x 11.0 mm
x_limit_mount.stl x 4
x_stop.stl x 4
