phorton1/Arduino-esp32_cnc20mm/docs/fusion/stl_other/two_two_base.stl

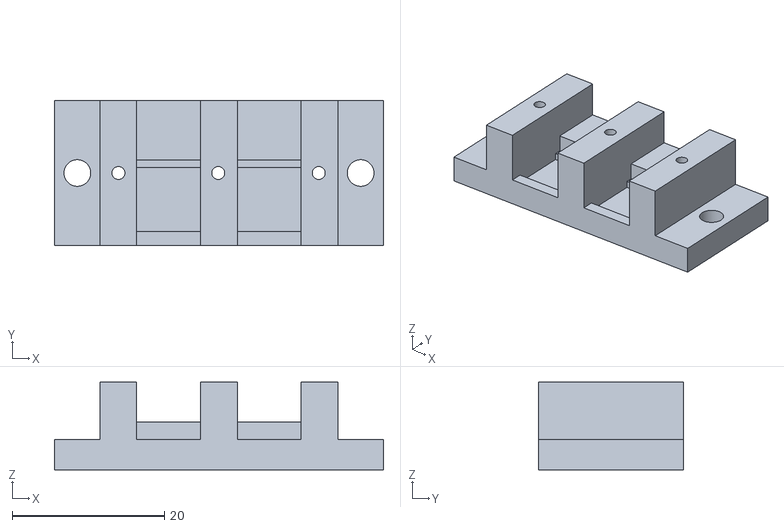
[picture p166: CAD file, 2023-07-21]
docs/fusion/stl_other/two_two_base.stl
43.2 x 19.0 x 11.5
