phorton1/Arduino-esp32_cnc20mm/docs/prusa/machine/x_axis_parts.3mf

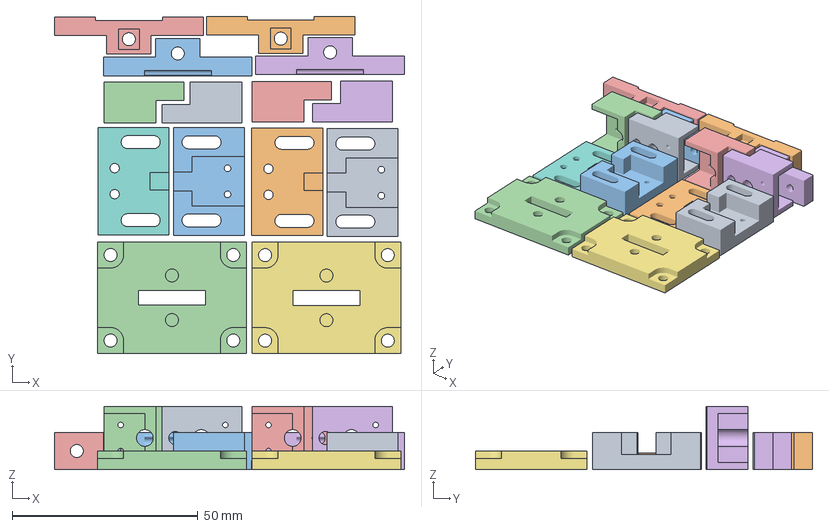
[picture p167: CAD file, 2023-07-21]
docs/prusa/machine/x_axis_parts.3mf
94.1 x 90.7 x 17.0 mm
x_limit_mount.stl x 4
y_limit_cover.stl x 2
y_limit_base.stl x 2
y_tensioner_plate.stl x 2
y_tensioner_top.stl x 2
y_tensioner_bottom.stl x 2
