phorton1/Arduino-esp32_cnc20mm/docs/fusion/stl_machine/z_stop.stl

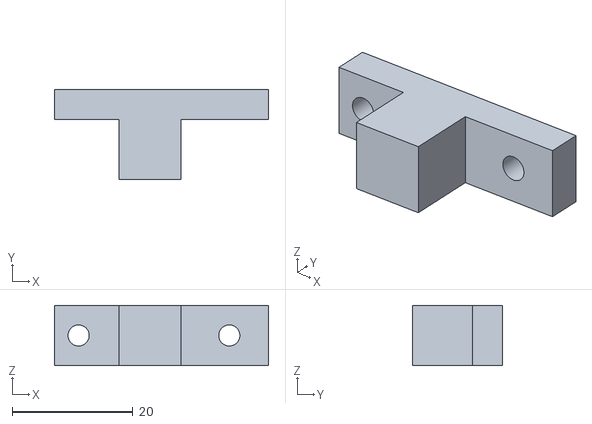
[picture p168: CAD file, 2023-07-21]
docs/fusion/stl_machine/z_stop.stl
35.5 x 15.0 x 9.99
