phorton1/Arduino-esp32_cnc20mm/docs/fusion/stl_machine/x_end_top.stl

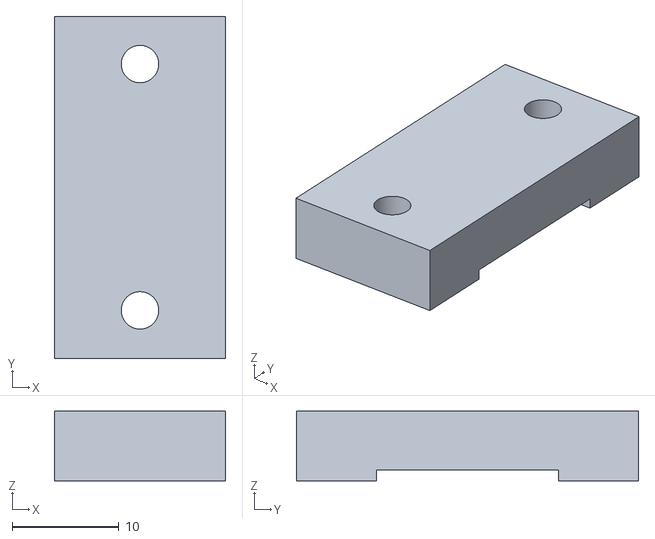
[picture p169: CAD file, 2023-07-21]
docs/fusion/stl_machine/x_end_top.stl
16.0 x 32.0 x 6.54
