phorton1/Arduino-esp32_cnc20mm/docs/fusion/stl_other/four_three_top.stl

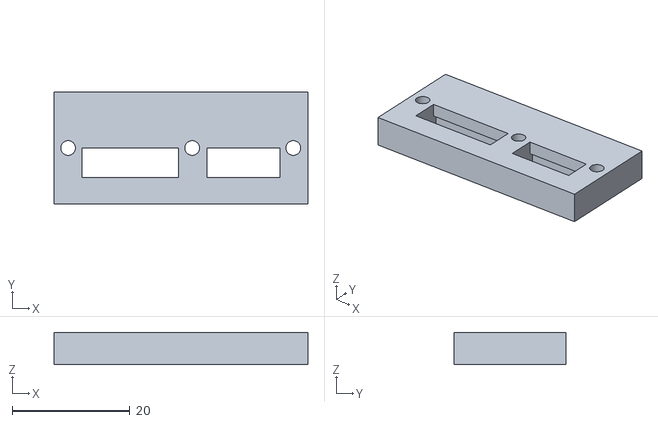
[picture p170: CAD file, 2023-07-21]
docs/fusion/stl_other/four_three_top.stl
43.2 x 19.0 x 5.50
