phorton1/Arduino-esp32_cnc20mm/docs/fusion/stl_machine/x_adj_end.stl

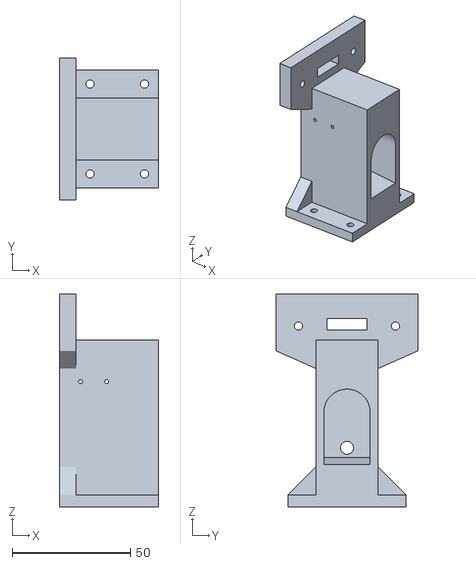
[picture p171: CAD file, 2023-07-21]
docs/fusion/stl_machine/x_adj_end.stl
42.0 x 60.0 x 90.0
