phorton1/Arduino-esp32_cnc20mm/docs/fusion/stl_other/two_two_top.stl

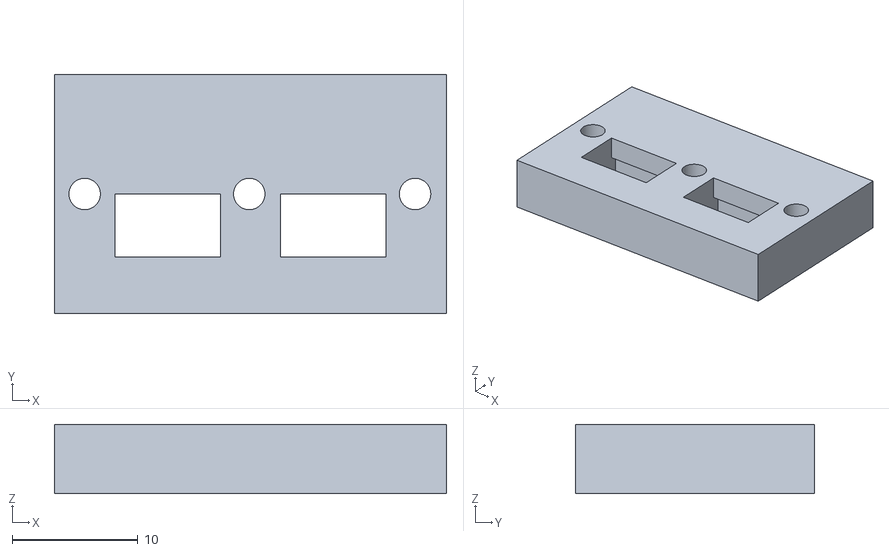
[picture p172: CAD file, 2023-07-21]
docs/fusion/stl_other/two_two_top.stl
31.2 x 19.0 x 5.50
