phorton1/Arduino-esp32_cnc20mm/docs/fusion/stl_other/four_top.stl

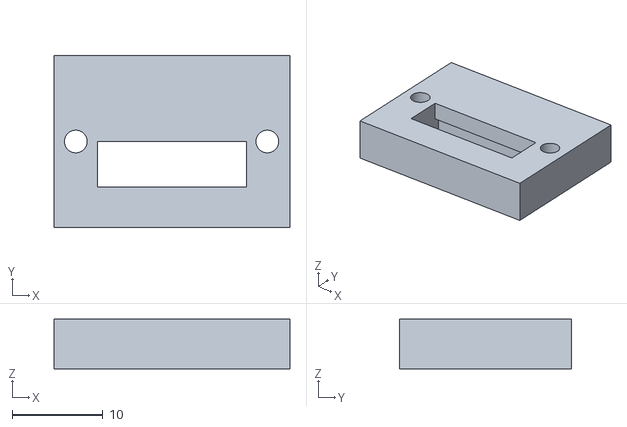
[picture p173: CAD file, 2023-07-21]
docs/fusion/stl_other/four_top.stl
26.0 x 19.0 x 5.50
