phorton1/Arduino-esp32_cnc20mm/docs/fusion/stl_machine/y_drag_spacer.stl

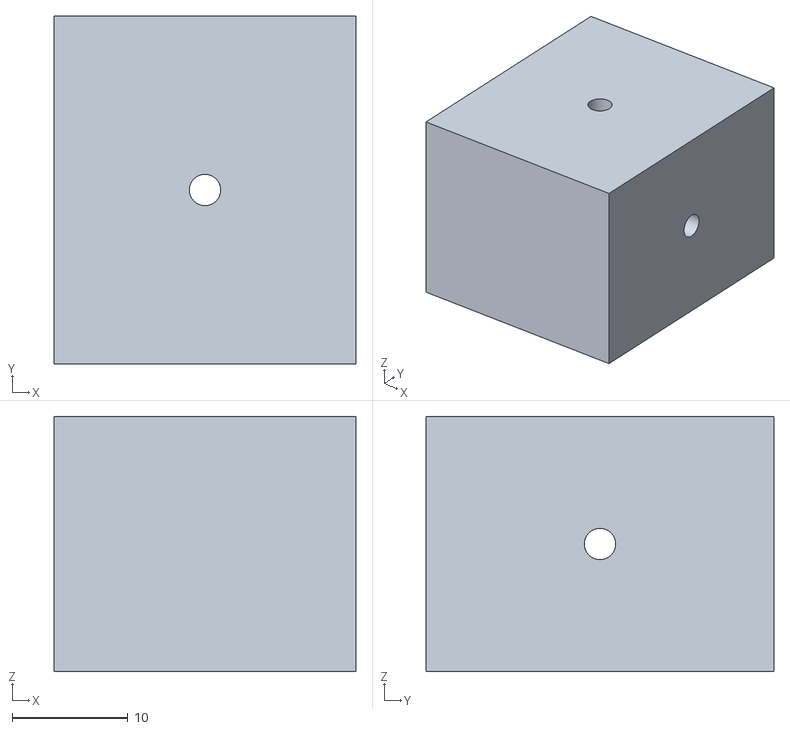
[picture p174: CAD file, 2023-07-21]
docs/fusion/stl_machine/y_drag_spacer.stl
26.0 x 30.0 x 22.0
