phorton1/Arduino-esp32_cnc20mm/docs/fusion/stl_machine/y_connector_clamp.stl

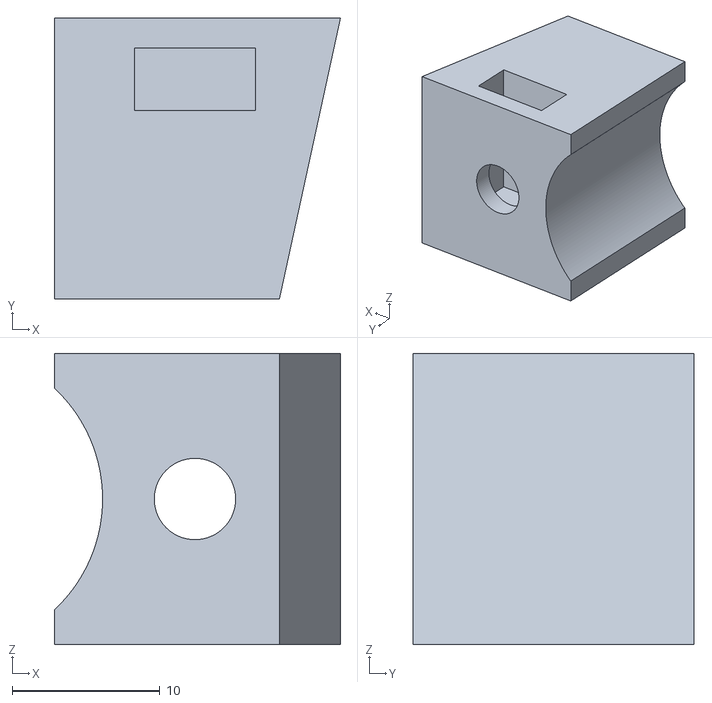
[picture p175: CAD file, 2023-07-21]
docs/fusion/stl_machine/y_connector_clamp.stl
19.3 x 19.0 x 19.7
