phorton1/Arduino-esp32_cnc20mm/docs/fusion/stl_machine/x_stop.stl

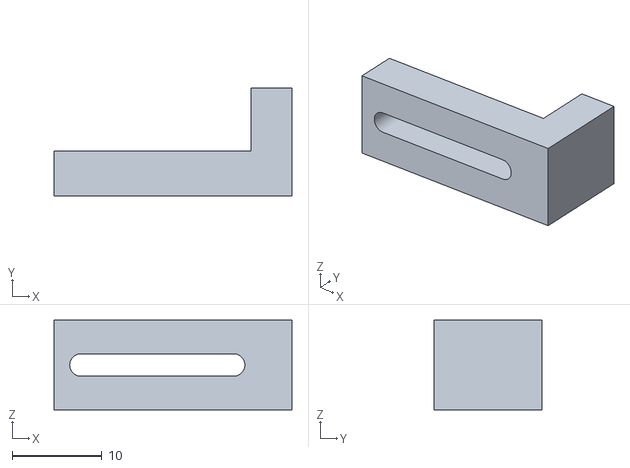
[picture p176: CAD file, 2023-07-21]
docs/fusion/stl_machine/x_stop.stl
26.5 x 12.0 x 10.0
