phorton1/Arduino-esp32_cnc20mm/docs/fusion/stl_machine/x_bar_tensioner.stl

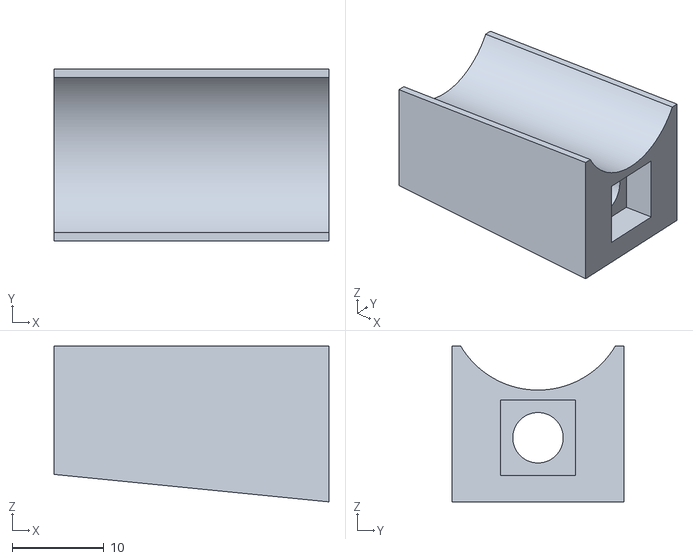
[picture p177: CAD file, 2023-07-21]
docs/fusion/stl_machine/x_bar_tensioner.stl
30.0 x 18.8 x 17.0
