phorton1/Arduino-esp32_cnc20mm/docs/fusion/stl_machine/y_limit_cover.stl

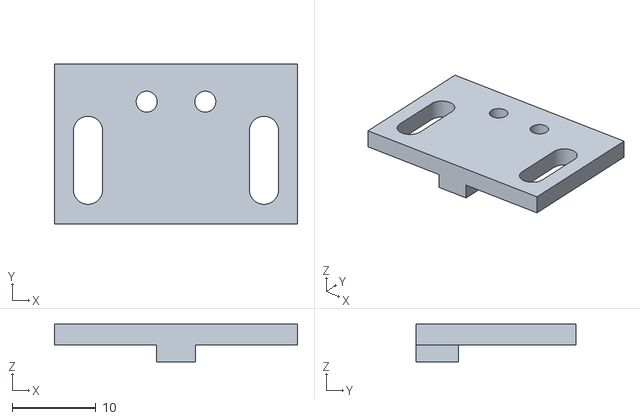
[picture p178: CAD file, 2023-07-21]
docs/fusion/stl_machine/y_limit_cover.stl
29.0 x 19.1 x 4.50
