phorton1/Arduino-esp32_cnc20mm/docs/fusion/stl_machine/y_connector.stl

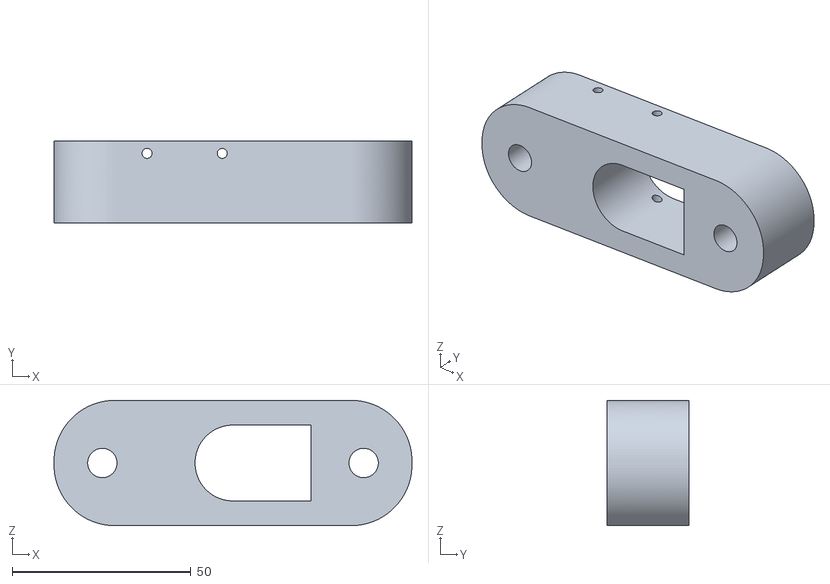
[picture p179: CAD file, 2023-07-21]
docs/fusion/stl_machine/y_connector.stl
100.0 x 23.0 x 35.0
