phorton1/Arduino-esp32_cnc20mm/docs/fusion/stl_machine/x_limit_mount.stl

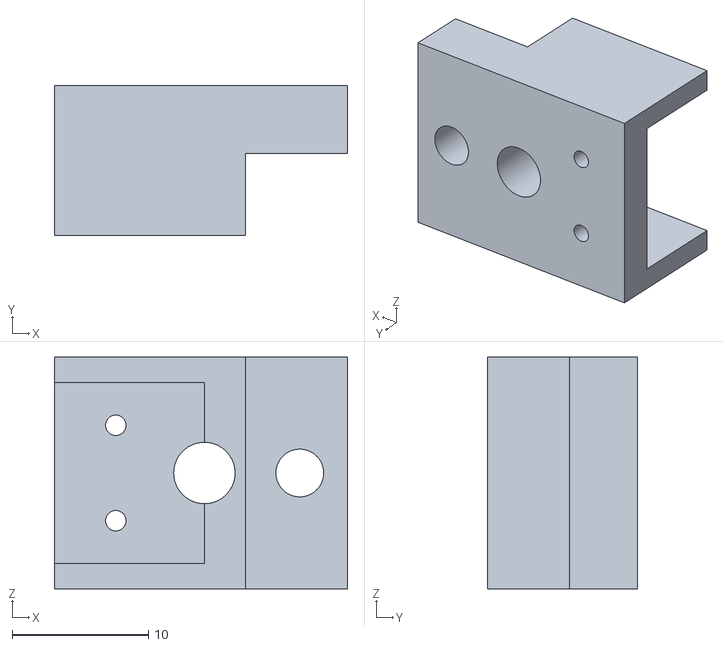
[picture p180: CAD file, 2023-07-21]
docs/fusion/stl_machine/x_limit_mount.stl
21.5 x 11.0 x 17.0
