phorton1/Arduino-esp32_cnc20mm/(list of files, cad)

Other CAD files:
docs/prusa/box/big_mount.3mf
docs/prusa/other/vacuum2_hose_connector.3mf
docs/prusa/machine/drag_support_bracket.3mf
docs/fusion/stl_box/power_connector_mount.stl
docs/fusion/stl_box/left_plastic.stl
docs/fusion/stl_machine/x_tube_support.stl
docs/fusion/stl_box/spindle_box_cover.stl
docs/fusion/stl_other/vacuum_base.stl
docs/fusion/stl_other/spindle_box_cover.stl
docs/prusa/machine/last_grey_parts.3mf
docs/fusion/stl_machine/z_zero_base.stl
docs/fusion/stl_other/10mm_hose_clamp.stl
docs/prusa/machine/y_tensioner.3mf
docs/fusion/stl_machine/x_tensioner.stl
docs/fusion/stl_machine/z_zero_cover.stl
docs/fusion/10mm_hose_clamp.f3d
docs/fusion/Air_Compressor_Experiment.f3d
docs/fusion/SPINDLE_BOX.f3z
docs/fusion/brushless_vac.f3z
docs/fusion/stl_other/washers.stl
docs/fusion/vacuum_box.f3z
docs/fusion/washers.f3d
docs/prusa/other/washers.3mf
