phorton1/Arduino-esp32_cnc20mm/docs/kicad/laser_board/laser_board.kicad_pcb

## KiCad design docs/kicad/laser_board/laser_board.kicad_pcb (2023-07-28)

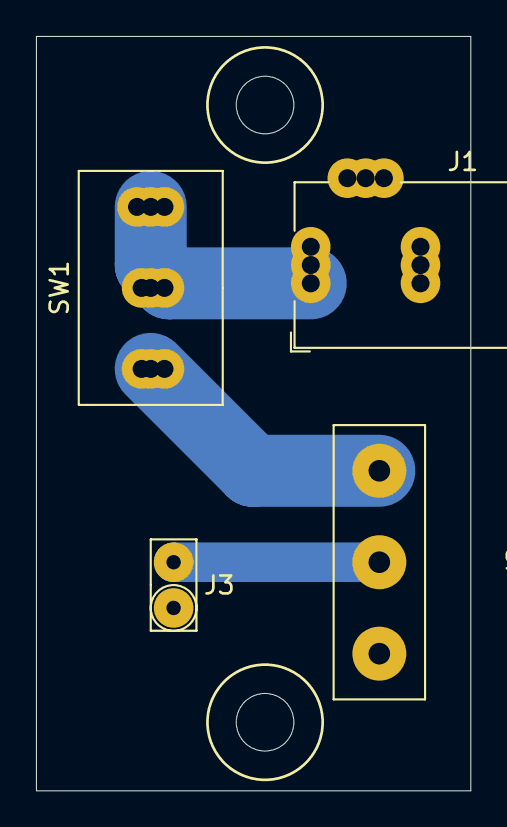
[picture p197: board laser_board.kicad_pcb from above]

Board: 2 copper layers, 24.1 x 41.9 mm, 4 parts (0 on the bottom side), 4 nets.

Parts:
J1: Barrel_Jack_Switch; myBarrelJack
J2: Conn_01x03; Phoenix5.08x3
J3: Conn_01x02; my2pin
SW1: SW_SPDT; mySwitchToggleSPDT

Connections:
unnamed: J1.1, SW1.1, SW1.2
unnamed: J1.2, J2.3, J3.1
unnamed: J2.1, SW1.3
unnamed: J2.2, J3.2
