phorton1/Arduino-esp32_cnc20mm/docs/kicad/vacuum_pcb/vacuum_pcb.kicad_pcb

## KiCad design docs/kicad/vacuum_pcb/vacuum_pcb.kicad_pcb (2023-07-27)

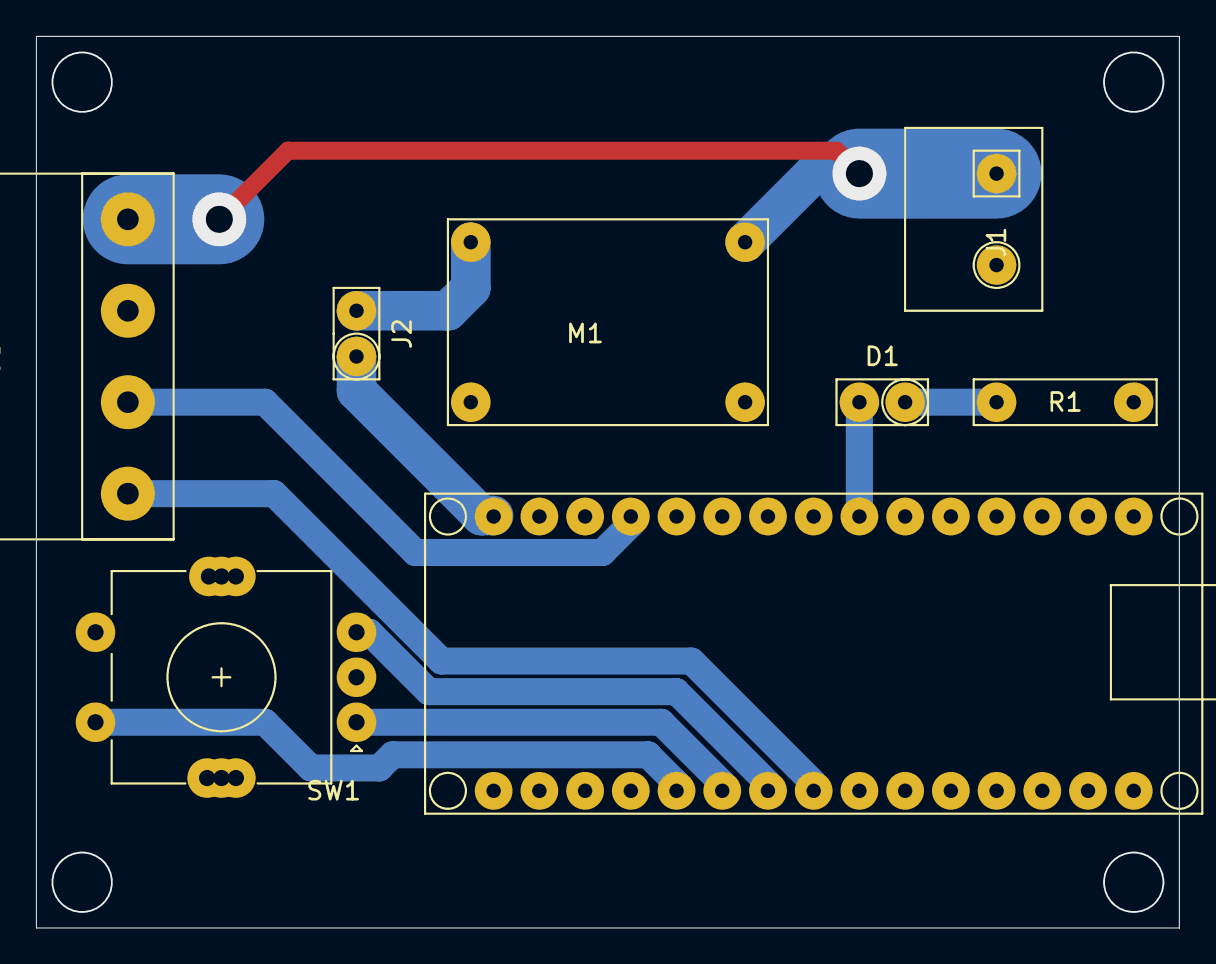
[picture p198: board vacuum_pcb.kicad_pcb from above]

Board: 2 copper layers, 63.5 x 49.5 mm, 8 parts (0 on the bottom side), 11 nets.

Parts:
D1: LED; my2pin
J1: 24v; mySkip1
J2: 5V Jumper; my2pin
J3: Conn_01x04; big_4pin
M1: BUCK01
R1: 220; myResistor
SW1: RE; RotaryEncoder
U1: ARDUINO_NANO

Connections:
GND: J1.2, J3.3, M1.1, M1.2, R1.2, SW1.C, SW1.S2, U1.2, U1.27
unnamed: D1.1, R1.1
unnamed: D1.2, U1.9
unnamed: J1.1, J3.4, M1.4
unnamed: J2.1, U1.1
unnamed: J2.2, M1.3
unnamed: J3.1, U1.23
unnamed: J3.2, U1.4
unnamed: SW1.A, U1.25
unnamed: SW1.B, U1.24
unnamed: SW1.S1, U1.26
