phorton1/Arduino-esp32_cnc20mm/docs/kicad/_controller4/controller4.kicad_pcb

## KiCad design docs/kicad/_controller4/controller4.kicad_pcb (2023-07-17)

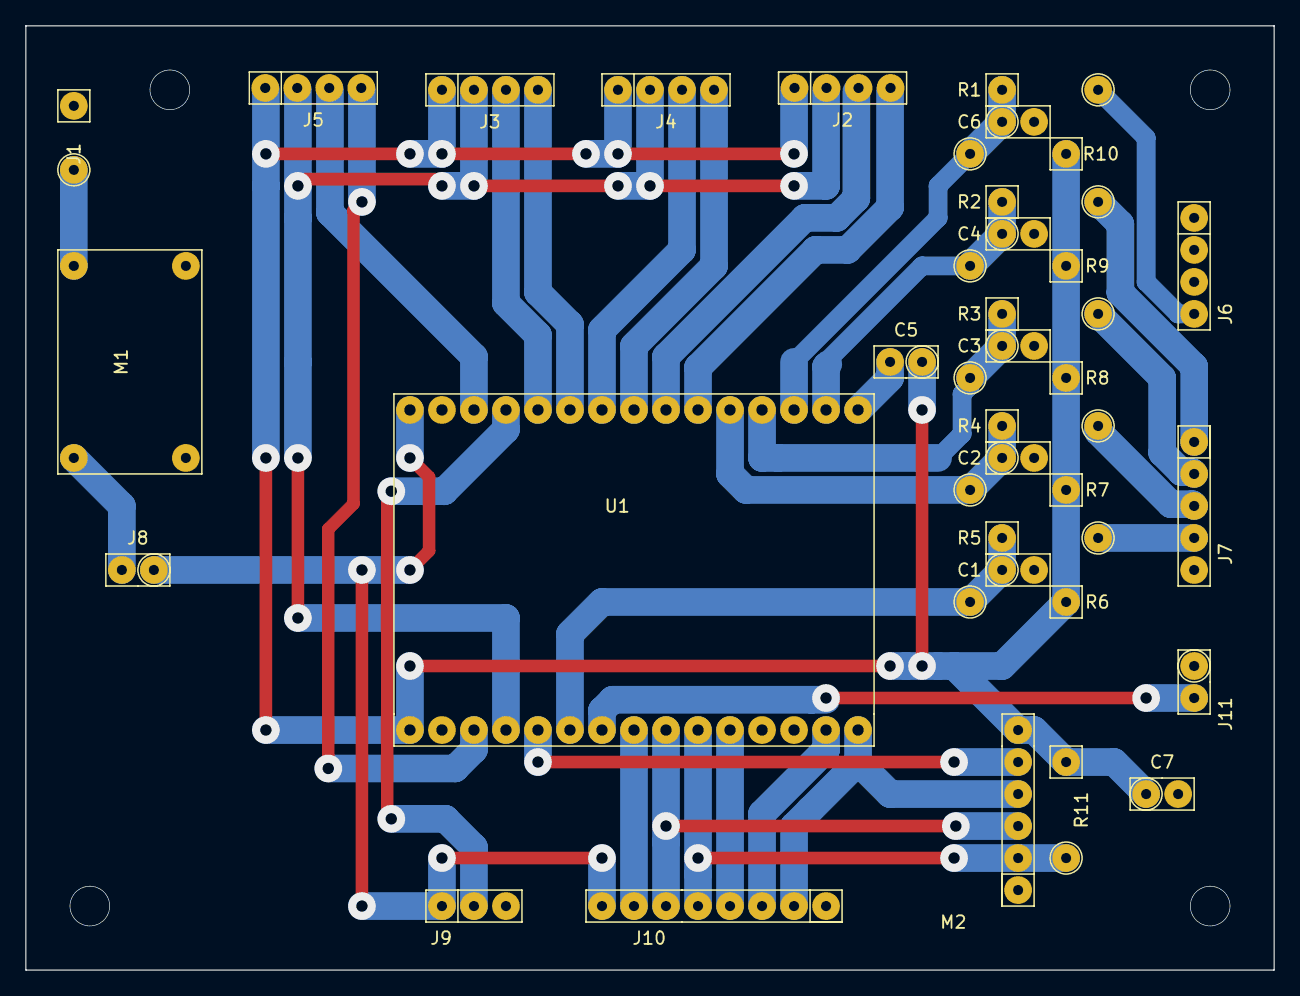
[picture p199: board controller4.kicad_pcb from above]

Board: 2 copper layers, 99.1 x 74.9 mm, 32 parts (0 on the bottom side), 34 nets.

Parts:
C1, C2, C3, C4, C6: 100nf; my2pin
C5: 10uF; my2pin
C7: 220uf 10V; my2pin
J1: 24V; mySkip1
J2: Z_AXIS; my4pin
J3: A_AXIS; my4pin
J4: Y_AXIS; my4pin
J5: X_AXIS; my4pin
J6: PROBE; my4pin
J7: LIMITS; my5Pin
J8: USB 5V; my2pin
J9: LEDS; my3pin
J10: DISPLAY; my8Pin
J11: PWM; my2pin
M1: BUCK01
M2: SD CARD; my6Pin
R1, R2, R3, R4, R5: 100; mySkip2
R6, R7, R8, R9, R10, R11: 10K; mySkip2
U1: ESP32_DEV_0; ESP32-DEV_0

Connections:
+3V3: C5.1, C7.1, J2.1, J3.1, J4.1, J5.1, M2.6, R6.1, R7.1, R8.1, R9.1, R10.1, R11.1, U1.30
+5V: J8.1, J9.1, J10.8, U1.1
A_DIR: J3.3, U1.5
A_STEP: J3.4, U1.6
A_SW: C3.1, R3.1, R8.2, U1.12
GND: C1.2, C2.2, C3.2, C4.2, C6.2, C7.2, J1.1, J7.5, J9.3, J10.1, J11.1, M1.1, M1.2, M2.1, U1.2, U1.29
LED: J9.2, U1.4
MCLK: J10.6, M2.3, U1.22
MISO: J10.5, M2.2, R11.2, U1.21
MOSI: J10.2, M2.4, U1.16
unnamed: C5.2, U1.15
unnamed: J1.2, M1.4
unnamed: J6.4, R1.2
unnamed: J7.1, R2.2
unnamed: J7.2, R3.2
unnamed: J7.3, R4.2
unnamed: J7.4, R5.2
unnamed: J8.2, M1.3
PROBE_SW: C6.1, R1.1, R10.2, U1.13
PWM: J11.2, U1.24
SD_CS: M2.5, U1.26
STEP_EN: J2.2, J3.2, J4.2, J5.2, U1.27
TFT_CS: J10.3, U1.17
TFT_DC: J10.4, U1.20
TOUCH_CS: J10.7, U1.23
X_DIR: J2.3, U1.9
X_STEP: J2.4, U1.10
X_SW: C1.1, R5.1, R6.2, U1.25
Y_DIR: J4.3, U1.7
Y_STEP: J4.4, U1.8
Y_SW: C2.1, R4.1, R7.2, U1.11
Z_DIR: J5.3, U1.3
Z_STEP: J5.4, U1.28
Z_SW: C4.1, R2.1, R9.2, U1.14
