phorton1/Arduino-esp32_cnc20mm/docs/kicad/edge_connector/edge_connector.kicad_pcb

## KiCad design docs/kicad/edge_connector/edge_connector.kicad_pcb (2022-05-19)

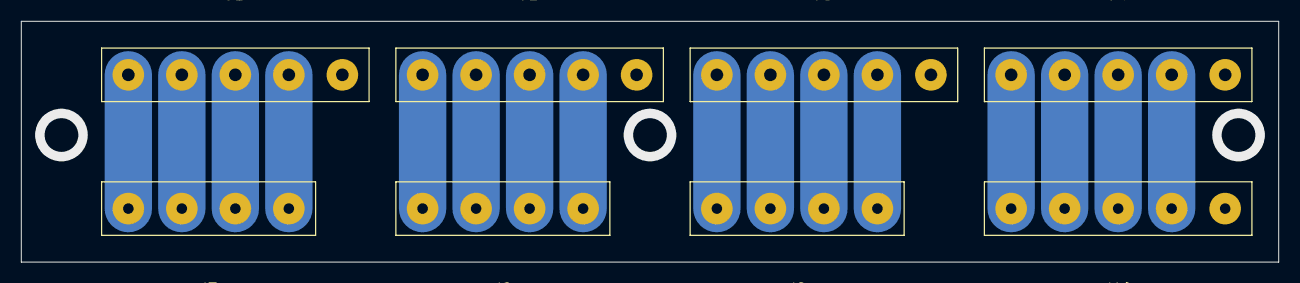
[picture p200: board edge_connector.kicad_pcb from above]

Board: 2 copper layers, 119.4 x 22.9 mm, 8 parts (0 on the bottom side), 17 nets.

Parts:
J1, J2, J3, J4, J10: Conn_01x05; big_5pin
J7, J8, J9: Conn_01x04; big_4pin

Connections:
GND: J1.5, J2.5, J3.5, J4.5, J10.1
unnamed: J1.1, J7.4
unnamed: J1.2, J7.3
unnamed: J1.3, J7.2
unnamed: J1.4, J7.1
unnamed: J2.1, J8.4
unnamed: J2.2, J8.3
unnamed: J2.3, J8.2
unnamed: J2.4, J8.1
unnamed: J3.1, J9.4
unnamed: J3.2, J9.3
unnamed: J3.3, J9.2
unnamed: J3.4, J9.1
unnamed: J4.4, J10.2
unnamed: J4.3, J10.3
unnamed: J4.2, J10.4
unnamed: J4.1, J10.5
