phorton1/Arduino-esp32_cnc20mm/docs/kicad/_controller3.0/controller.kicad_pcb

## KiCad design docs/kicad/_controller3.0/controller.kicad_pcb (2022-04-10)

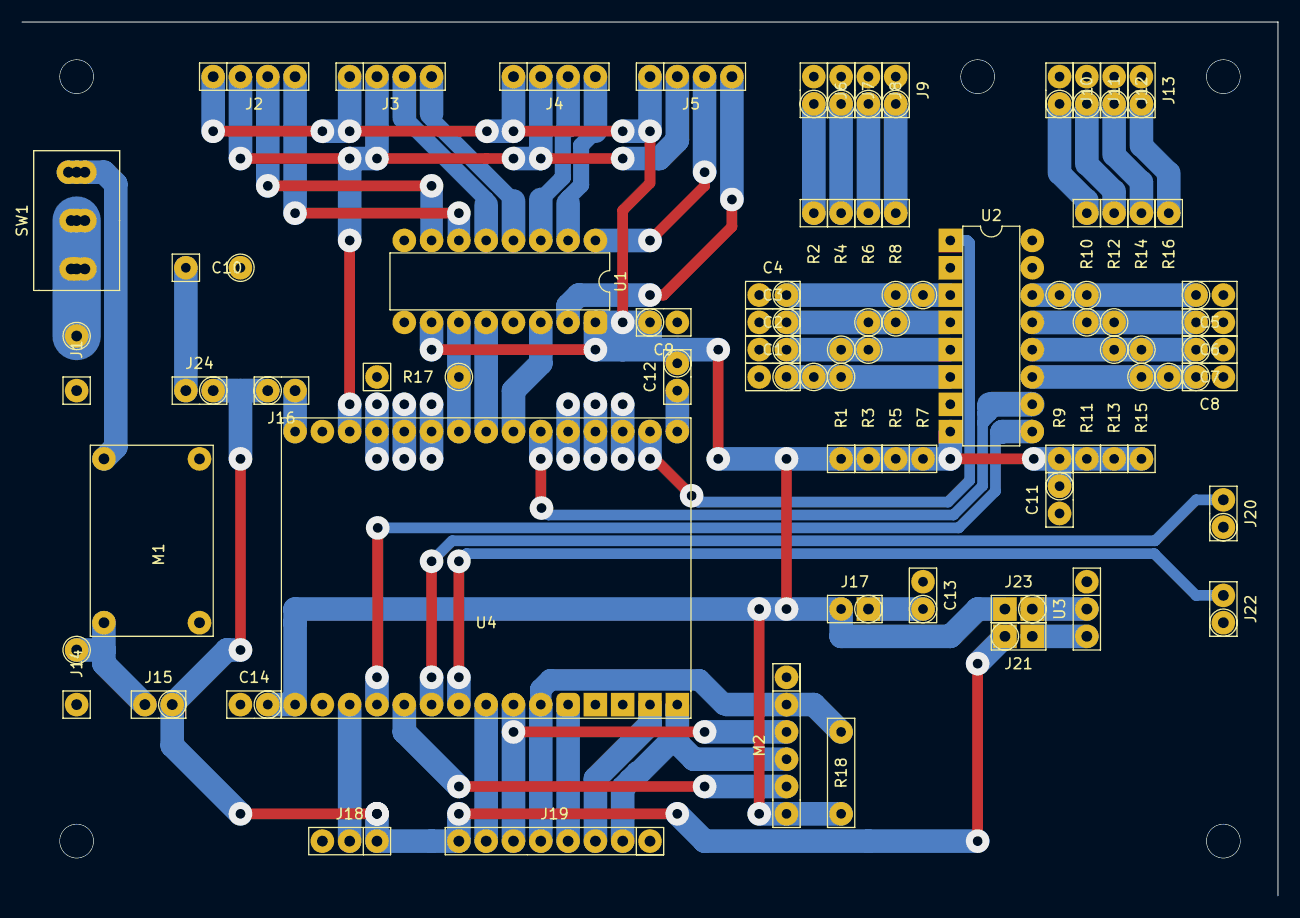
[picture p201: board controller.kicad_pcb from above]

Board: 2 copper layers, 116.8 x 81.3 mm, 63 parts (0 on the bottom side), 53 nets.

Parts:
C1, C2, C3, C4, C5, C6, C7, C8, C9, C11, C14: 100nf; my2pin
C10: 330uf 50v; mySkip1
C12: 10uF; my2pin
C13: 220uf 10V; my2pin
J1: 24V; mySkip1
J2: X_AXIS; my4pin
J3: A_AXIS; my4pin
J4: Y_AXIS; my4pin
J5: Z_AXIS; my4pin
J6: X_ZERO; my2pin
J7: X_LIM; my2pin
J8: Y_ZERO; my2pin
J9: Y_LIM; my2pin
J10: Z_ZERO; my2pin
J11: Z_LIM; my2pin
J12: PROBE; my2pin
J13: UNUSED; my2pin
J14: 5V; mySkip1
J15: EXT 5V; my2pin
J16: USB 5V; my2pin
J17: CAP3V; my2pin
J18: WS2812B Strip; my3pin
J19: Display; my8Pin
J20: PWM_1A; my2pin
J21: REG5V; my2pin
J22: PWM_2A; my2pin
J23: REG3V; my2pin
J24: CAP5V; my2pin
M1: BUCK01
M2: SD_TYP0; my6Pin
R1, R15, R17: 10K; mySkip2
R2, R16: 100; mySkip5
R3, R13: 10K; mySkip3
R4, R14: 100; mySkip4
R5, R11: 10K; mySkip4
R6, R12: 100; mySkip3
R7, R9: 10K; mySkip5
R8, R10: 100; mySkip2
R18: 10K; myResistor
SW1: POWER; SW_DPDT_BLUE_LEVER
U1: 74HC595; myDip16
U2: 74HC165; myDip16
U3: LM1117; my3pin
U4: ESP32_DEV_0; ESP32-DEV_0

Connections:
+3V3: C9.1, C11.1, C12.1, C14.1, J2.1, J3.1, J4.1, J5.1, J17.2, J23.2, M2.6, R1.1, R3.1, R5.1, R7.1, R9.1, R11.1, R13.1, R15.1, R18.1, U1.10, U1.16, U2.8, U4.30
+5V: J15.1, J16.1, J18.1, J19.8, J21.1, J24.1
+24V: M1.4, SW1.1
A_DIR: J3.3, U1.5
A_STEP: J3.4, U1.4
GND: C1.2, C2.2, C3.2, C4.2, C5.2, C6.2, C7.2, C8.2, C9.2, C10.2, C11.2, C13.2, C14.2, J1.1, J6.2, J7.2, J8.2, J9.2, J10.2, J11.2, J12.2, J13.2, J14.1, J18.3, J19.1, J20.1, J22.1, M1.1, M1.2, M2.1, R17.1, U1.8, U1.13, U2.2, U2.7, U2.16, U3.1, U4.2, U4.29
I2S_BCK: R17.2, U1.11, U4.7
I2S_DATA: U1.14, U4.9
I2S_WS: U1.12, U4.8
LED: J18.2, U4.28
MCLK: J19.6, M2.3, U4.22
MISO: J19.5, M2.2, R18.2, U4.21
MOSI: J19.2, M2.4, U4.16
unnamed: C1.1, R1.2, R2.2, U2.6
unnamed: C2.1, R3.2, R4.2, U2.5
unnamed: C3.1, R5.2, R6.2, U2.4
unnamed: C4.1, R7.2, R8.2, U2.3
unnamed: C5.1, R9.2, R10.2, U2.14
unnamed: C6.1, R11.2, R12.2, U2.13
unnamed: C7.1, R13.2, R14.2, U2.12
unnamed: C8.1, R15.2, R16.2, U2.11
unnamed: C10.1, J24.2
unnamed: C12.2, U4.15
unnamed: C13.1, J17.1
unnamed: J1.2, SW1.2, SW1.3
unnamed: J6.1, R2.1
unnamed: J7.1, R4.1
unnamed: J8.1, R6.1
unnamed: J9.1, R8.1
unnamed: J10.1, R10.1
unnamed: J11.1, R12.1
unnamed: J12.1, R14.1
unnamed: J13.1, R16.1
unnamed: J14.2, J15.2, M1.3
unnamed: J16.2, U4.1
unnamed: J21.2, U3.3
unnamed: J23.1, U3.2
PWM_1: J20.2, U4.25
PWM_2: J22.2, U4.24
SD_CS: M2.5, U4.26
STEP_EN: J2.2, J3.2, J4.2, J5.2, U4.3
SW_CLK: U2.10, U4.10
SW_DATA: U2.1, U4.14
SW_LATCH: U2.9, U4.27
TFT_CS: J19.3, U4.17
TFT_DC: J19.4, U4.20
TOUCH_CS: J19.7, U4.23
X_DIR: J2.3, U1.7
X_STEP: J2.4, U1.6
Y_DIR: J4.3, U1.3
Y_STEP: J4.4, U1.2
Z_DIR: J5.3, U1.1
Z_STEP: J5.4, U1.15
