phorton1/Arduino-esp32_cnc20mm/docs/kicad/lcd_connector/lcd_connector.kicad_pcb

## KiCad design docs/kicad/lcd_connector/lcd_connector.kicad_pcb (2022-03-28)

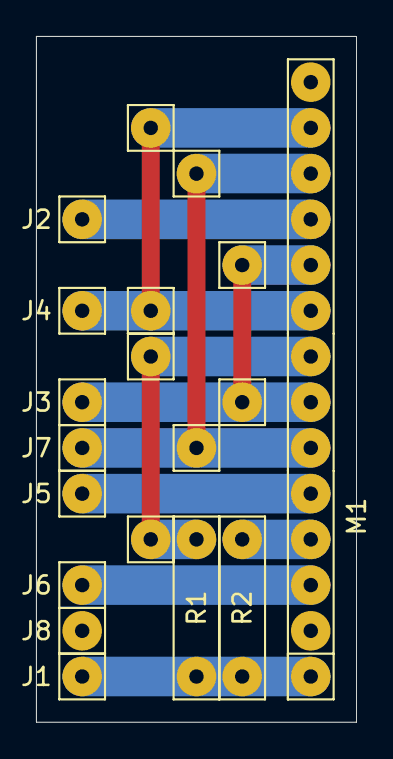
[picture p202: board lcd_connector.kicad_pcb from above]

Board: 2 copper layers, 17.8 x 38.1 mm, 19 parts (0 on the bottom side), 10 nets.

Parts:
J1: 5V; my1pin
J2: T_CS; my1pin
J3: CLK; my1pin
J4: MISO; my1pin
J5: DC; my1pin
J6: CS; my1pin
J7: MOSI; my1pin
J8: GND; my1pin
M1: TFT_ILI9341; my14Pin
R1: 100; myResistor
R2: 10K; myResistor
V1, V2, V3, V5, V6, V7, V8, V9: Conn_01x01; my1pin

Connections:
unnamed: J1.1, M1.1, R1.1, R2.1
unnamed: J2.1, M1.11
unnamed: J3.1, M1.7, M1.10, V3.1, V5.1
unnamed: J4.1, M1.9, M1.13, V6.1, V8.1
unnamed: J5.1, M1.5
unnamed: J6.1, M1.3
unnamed: J7.1, M1.6, M1.12, V7.1, V9.1
unnamed: J8.1, M1.2
unnamed: M1.4, R2.2
unnamed: M1.8, R1.2, V1.1, V2.1
