phorton1/Arduino-esp32_cnc20mm/docs/kicad/edge_connector/edge_connector_small.kicad_pcb

## KiCad design docs/kicad/edge_connector/edge_connector_small.kicad_pcb (2022-04-10)

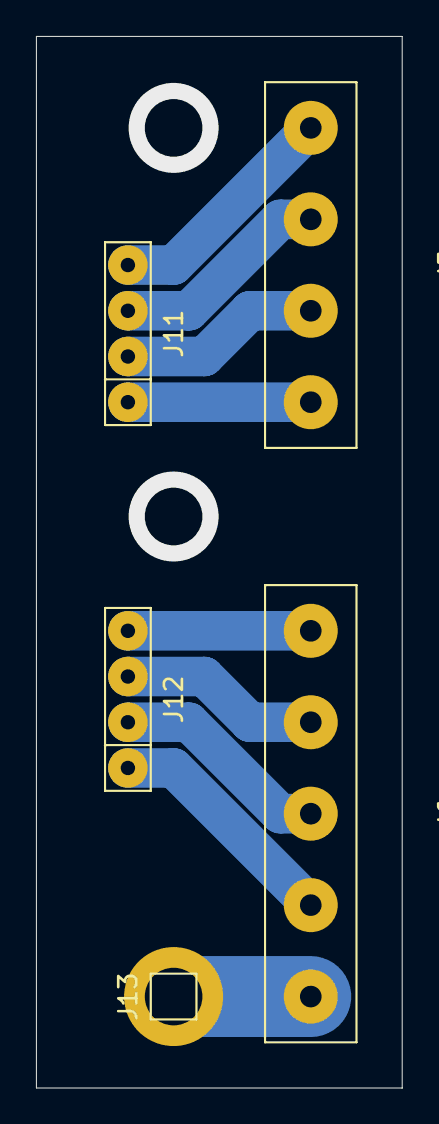
[picture p203: board edge_connector_small.kicad_pcb from above]

Board: 2 copper layers, 20.3 x 58.4 mm, 5 parts (0 on the bottom side), 9 nets.

Parts:
J5: Conn_01x04; big_4pin
J6: Conn_01x05; big_5pin
J11, J12: Conn_01x04; my4pin
J13: Conn_01x01; my1pin

Connections:
unnamed: J5.4, J11.1
unnamed: J5.3, J11.2
unnamed: J5.2, J11.3
unnamed: J5.1, J11.4
unnamed: J6.4, J12.1
unnamed: J6.3, J12.2
unnamed: J6.2, J12.3
unnamed: J6.1, J12.4
unnamed: J6.5, J13.1
