phorton1/Arduino-esp32_cnc20mm/(commit log)

2022-03-28 initial commit (from branch)
    [controller.kicad_pcb, controller.sch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]
2022-04-10 renamed config_v3_i2s0.yaml to config_cnc20mm.yaml, noting that the laser and non-laser are the same (as long as I have no PWM spindle)
2022-04-10 sanity checking after completing most circuit boards
    [controller.kicad_pcb, edge_connector.kicad_pcb, edge_connector.sch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]
2022-04-13 added spindle connector kicad stuff
    [spindle_connector.kicad_pcb, spindle_connector.sch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]
2022-04-13 added stepper wiring and full cnc pin_history (comments only)
2022-04-15 implement FluidNC_UI driver/size/rotation API - rename tft calibration data files
2022-04-15 Implement LIMIT_PINS and REVERSE_PIXELS
    [config.yaml, config_cnc20mm.yaml, pixels_20mm.cpp, pixels_20mm.h]
2022-05-19 change big edge connector to 5 pin (grounds for steppers)
    [edge_connector.kicad_pcb, edge_connector.sch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]
2022-07-05 added laser_board
    [laser_board.kicad_pcb, laser_board.sch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]
2022-07-05 cleanup configs (add Laser)
2022-07-05 correct probe pin
2022-07-29 changed (fixed) WEAK_LINK display() method (though it still doesnt work with UGS)
    [cnc20mm.cpp]
2022-07-29 changed PWM_HZ to 5000 which fixed some laser missing bands
    [config.yaml, config_cnc20mm.yaml]
2022-08-09 new controller4 (v4) circuit board
    [controller4.kicad_pcb, controller4.sch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]
2022-08-24 lower homing feed rates
2022-12-12 updated ground plane while reviewing docs and pcbs
    [controller4.kicad_pcb]
2023-03-21 make the current v4 configuration the default config.yaml
2023-07-17 docs - start writing actual documentation
    [controller4.kicad_pcb, controller4.sch]
2023-07-20 docs - work on design.md
    [parametric_machine.csv, wiring.sch]
2023-07-21 docs - post production materials, rework designs for publication
    [10mm_hose_clamp.3mf, 10mm_hose_clamp.stl, 4x4_machine_params.csv, SPINDLE_BOX.f3z, big_mount.3mf, big_mount.stl, connector_brackets.f3d, connector_brackets1.3mf]
2023-07-22 docs - completed redesign, ready to start working on docs again
    [4x4_machine_params.csv, connector_brackets.f3d, drag_support_bracket.3mf, drag_support_bracket.stl, wire_clamp.f3d]
2023-07-24 docs - rework whole fusion design
    [x_adj_end.3mf, x_bearing.stl, x_bearing_x_4.3mf, x_end_set.3mf, x_fixed_end.stl, y_bearing_x_2.3mf]
2023-07-25 docs - cleanup stl & gcode for publication
    [laser_scoop.3mf, laser_scoop.stl, vacuum2_hose_connector.3mf, vacuum2_hose_connector.stl, washers.3mf, washers.5.3mf, washers.5.stl, washers.stl]
2023-07-26 docs - design DETAILS and SPINDLE pages
2023-07-27 docs - fleshed out the TABLE, Y-AXIS, and BUILD pages
2023-07-27 docs - fleshed out LASER and ACESSORIES pages
    [10mm_hose_clamp.f3d, Air_Compressor_Experiment.f3d, brushless_vac.f3z, vacuum_box.f3z, vacuum_pcb.kicad_pcb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]
2023-07-28 docs - added Laser Board to laser page
    [laser_board.kicad_pcb, laser_board.sch, laser_board.step]
2023-11-02 fix broken links across all repos with introduction of base-apps-gitUI::repoDocs.pm
    [cnc20mm.cpp, cnc20mm.h, pixels_20mm.cpp]
